tetes20/bldc_driver/bldc_driver_hw/3d_model/ESP32-C6-MINI-1-H4.step

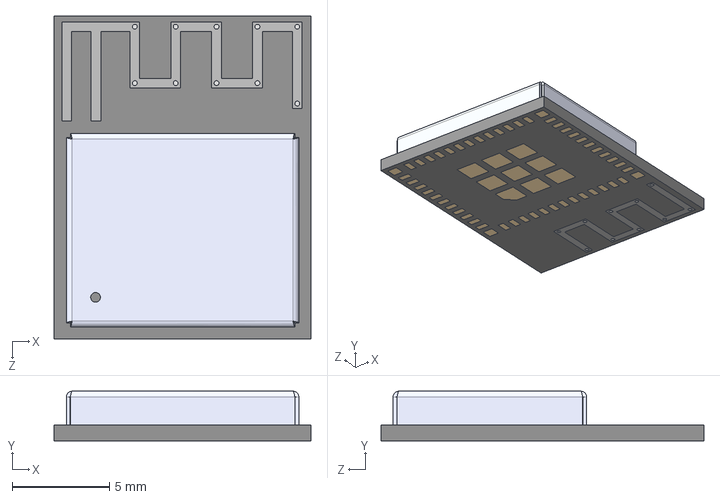
[picture p1: CAD file, 2025-04-09]
bldc_driver_hw/3d_model/ESP32-C6-MINI-1-H4.step
13.2 x 2.55 x 16.6 mm
