tetes20/bldc_driver/bldc_driver_hw/3d_model/LMLP0506M4R7DTAS.stp

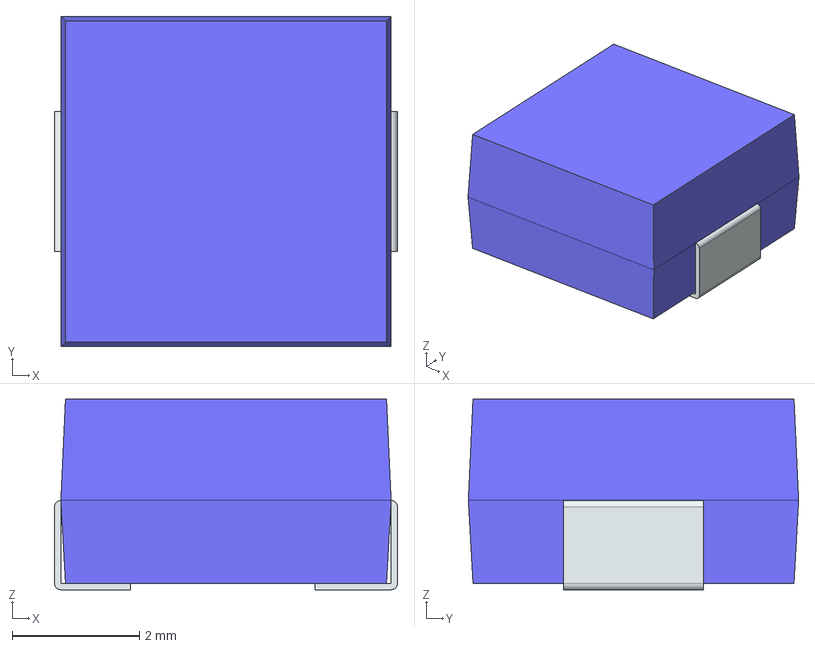
[picture p2: CAD file, 2025-04-08]
bldc_driver_hw/3d_model/LMLP0506M4R7DTAS.stp
5.40 x 5.20 x 3.00 mm
FilletPin1
FilletPin2
