tetes20/bldc_driver/bldc_driver_hw/3d_model/MR60-F.stp

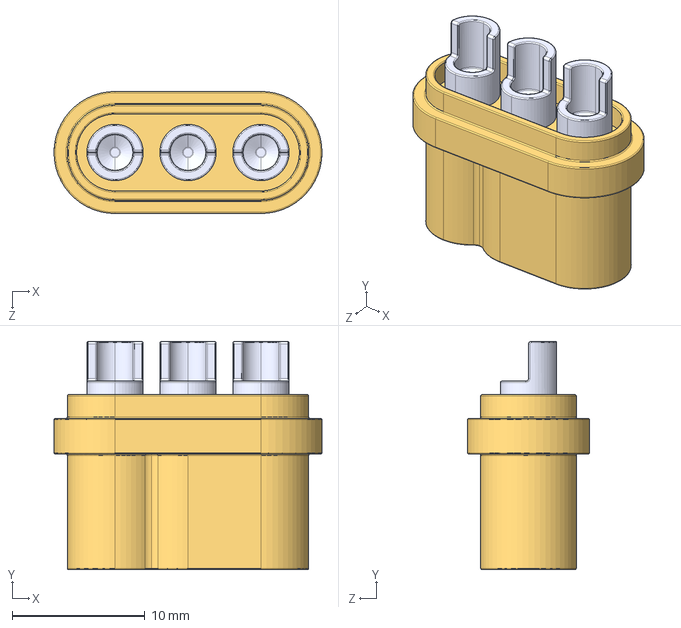
[picture p3: CAD file, 2025-04-08]
bldc_driver_hw/3d_model/MR60-F.stp
20.2 x 17.2 x 9.20 mm
Plug
Pin x 3
