tetes20/bldc_driver/bldc_driver_hw/3d_model/DRV8328BRUYR.stp

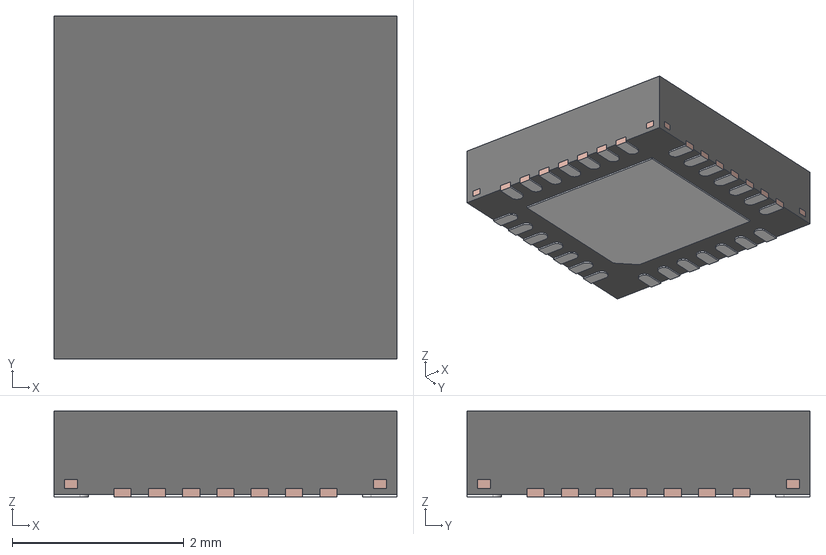
[picture p4: CAD file, 2025-04-05]
bldc_driver_hw/3d_model/DRV8328BRUYR.stp
4.00 x 4.00 x 1.00 mm
FRAME
