tetes20/bldc_driver/bldc_driver_hw/3d_model/DRV8334PHPR.stp

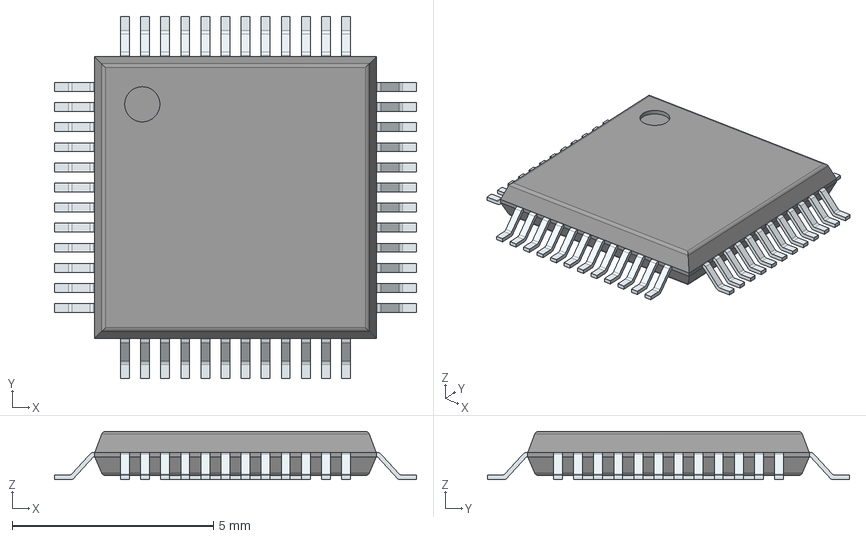
[picture p5: CAD file, 2025-04-03]
bldc_driver_hw/3d_model/DRV8334PHPR.stp
9.00 x 9.00 x 1.20 mm
PinsArrayLR
PinsArrayTB
ThermalPad
