tetes20/bldc_driver/bldc_driver_hw/plots/bldc_driver_hw__Assembly.pdf

1 | 2 | 3 | 4 | 5 | 6

A

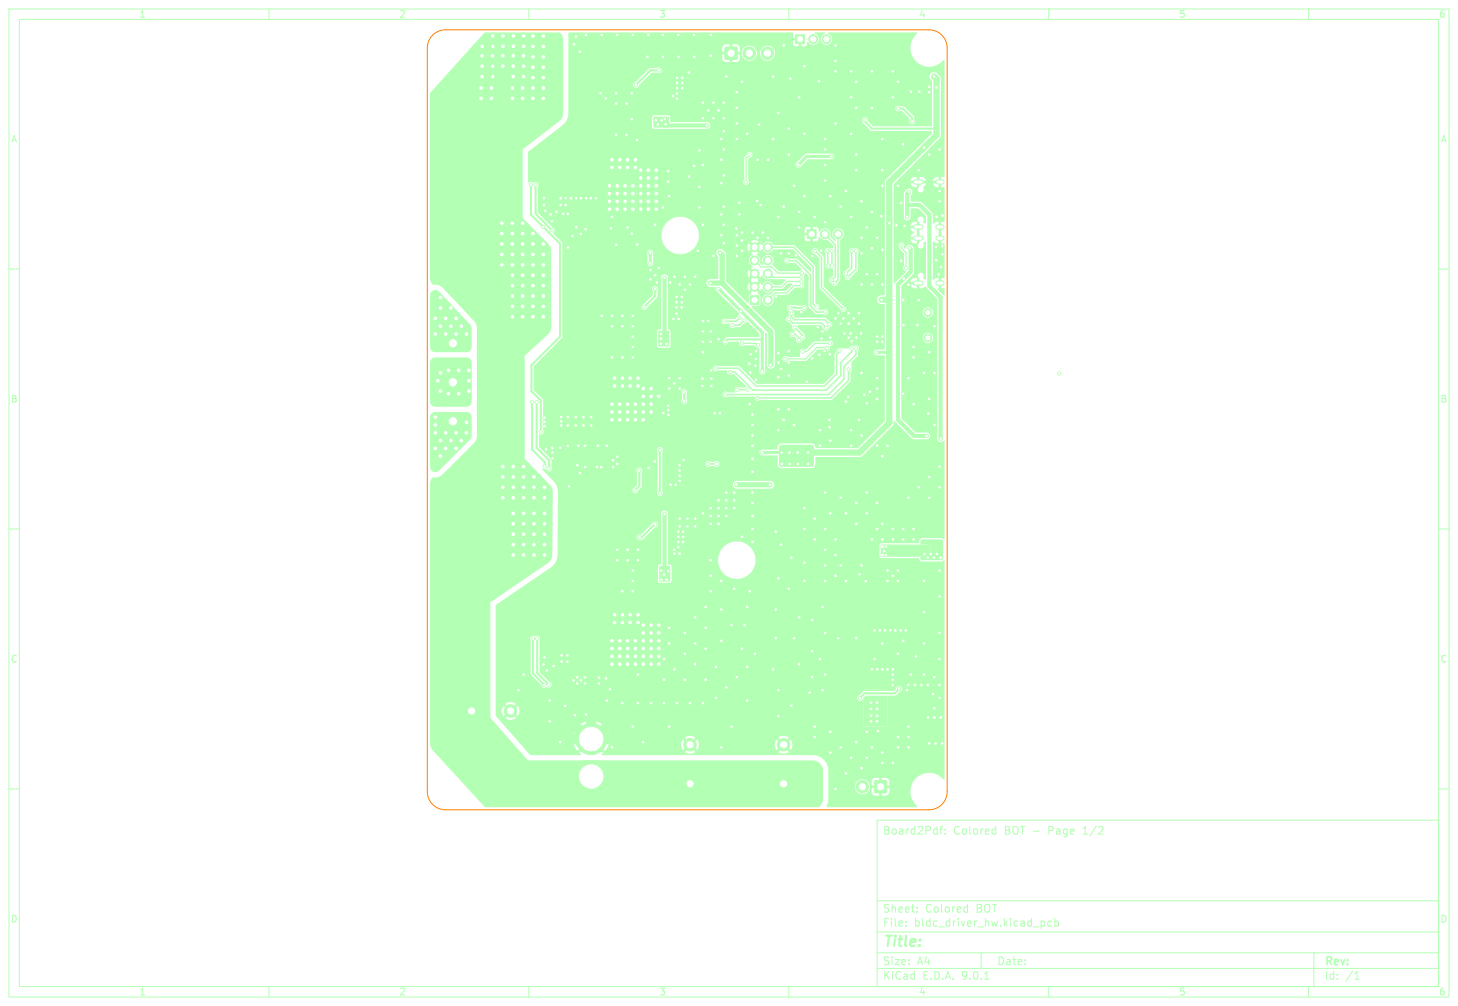
[picture p6: page 1]
D Date: KiCad; E.D.A. 9.0.1 Size: A4; Rev:; Id: /1 Title: File: bldc_driver_hw.kicad_pcb Sheet: Colored; BOT Board2Pdf:; Colored; BOT -; Page

1 | 2 | 3 | 4 | 5 | 6 1 | 2 | 3 | 4 | 5 | 6 ABCD | ABCD Date: KiCad | E.D.A. 9.0.1 Size: A4 | Rev:

## PHASE U

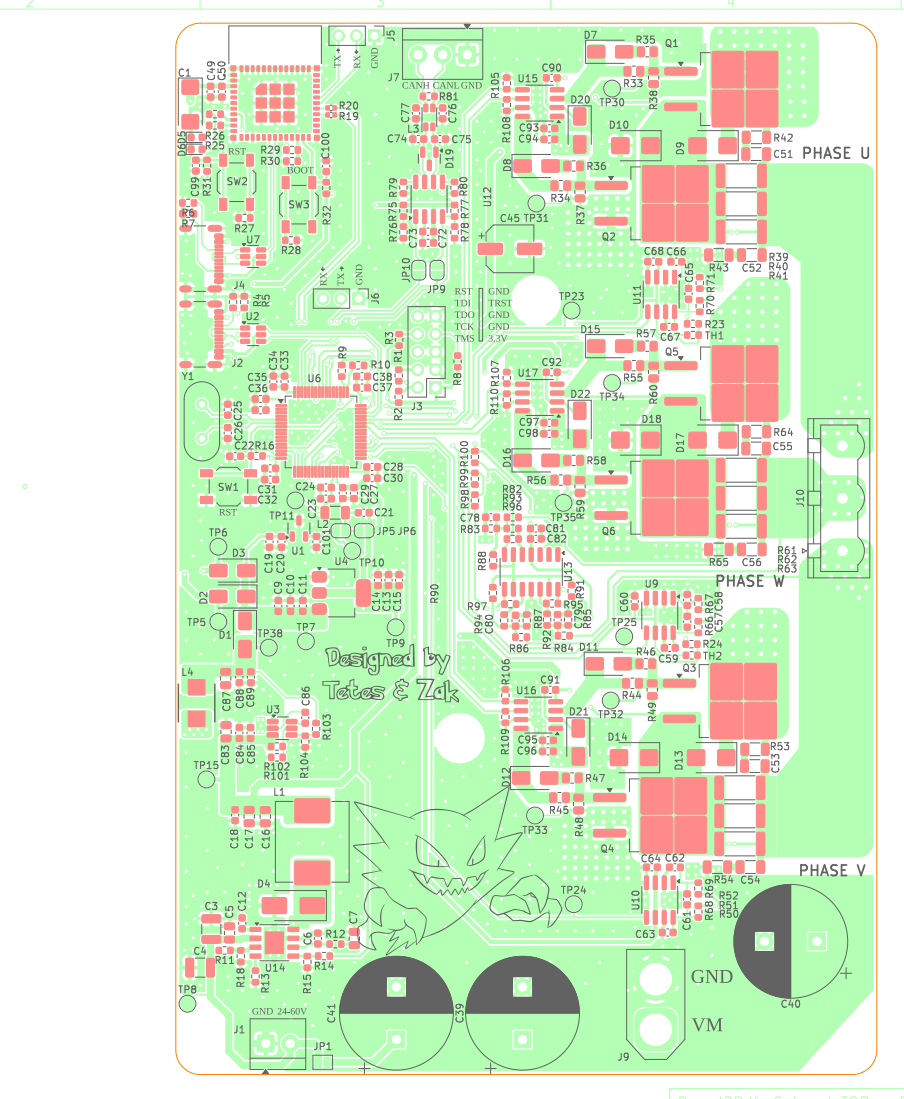
[picture p7: page 2]
