tetes20/bldc_driver/bldc_driver_hw/plots/bldc_driver_hw.pdf

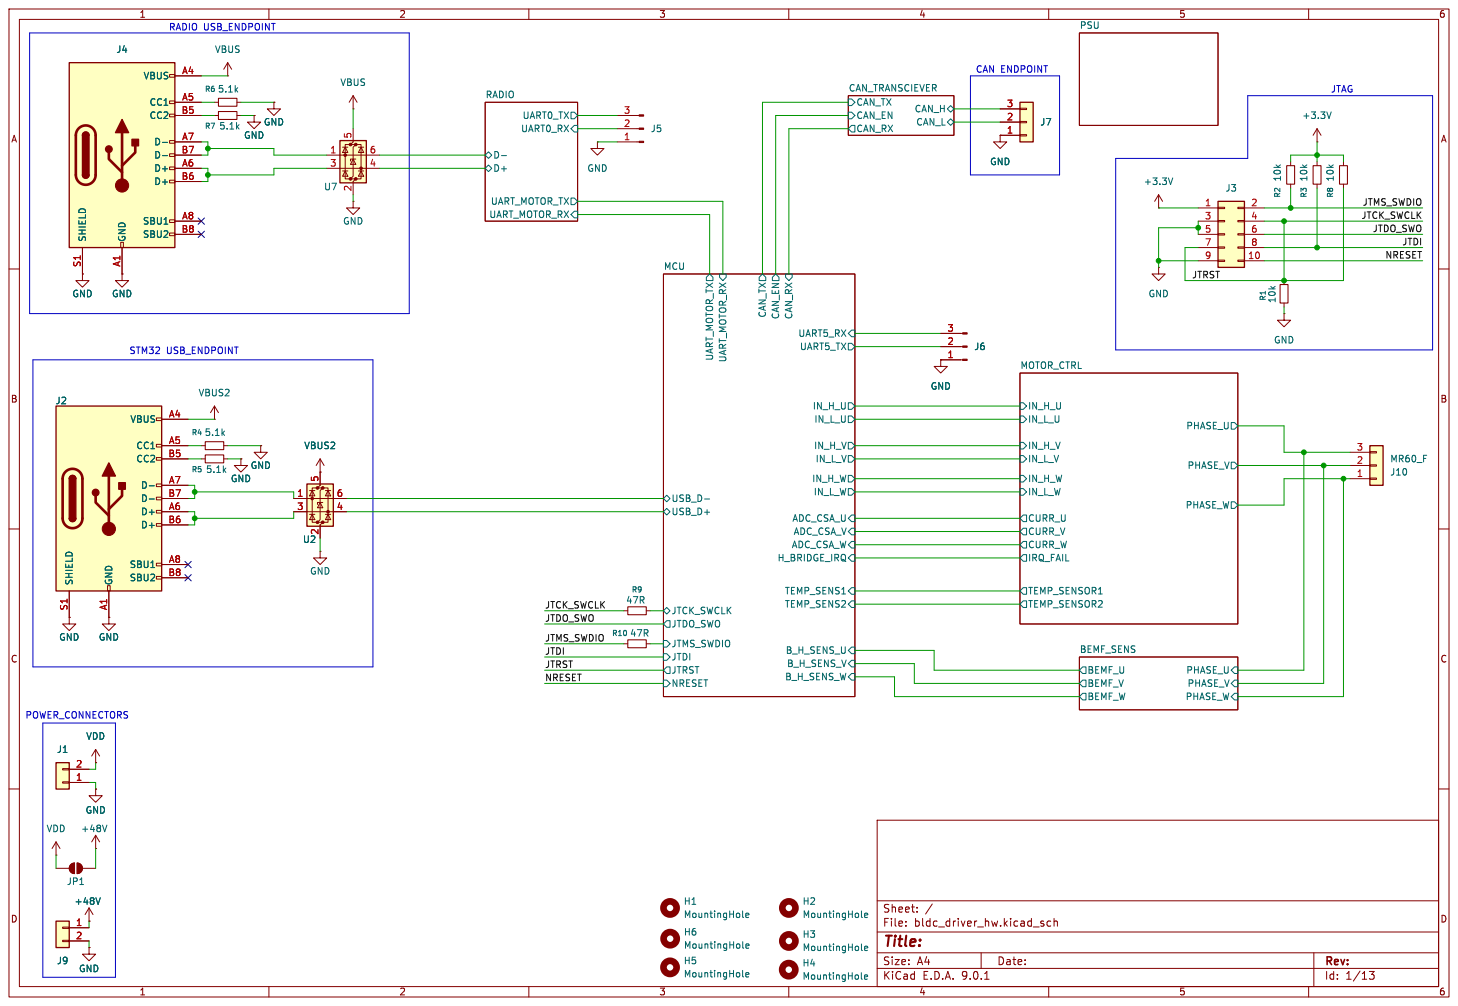
[picture p8: page 1]

Id: 1/13 Title: File: bldc_driver_hw.kicad_sch Sheet: /

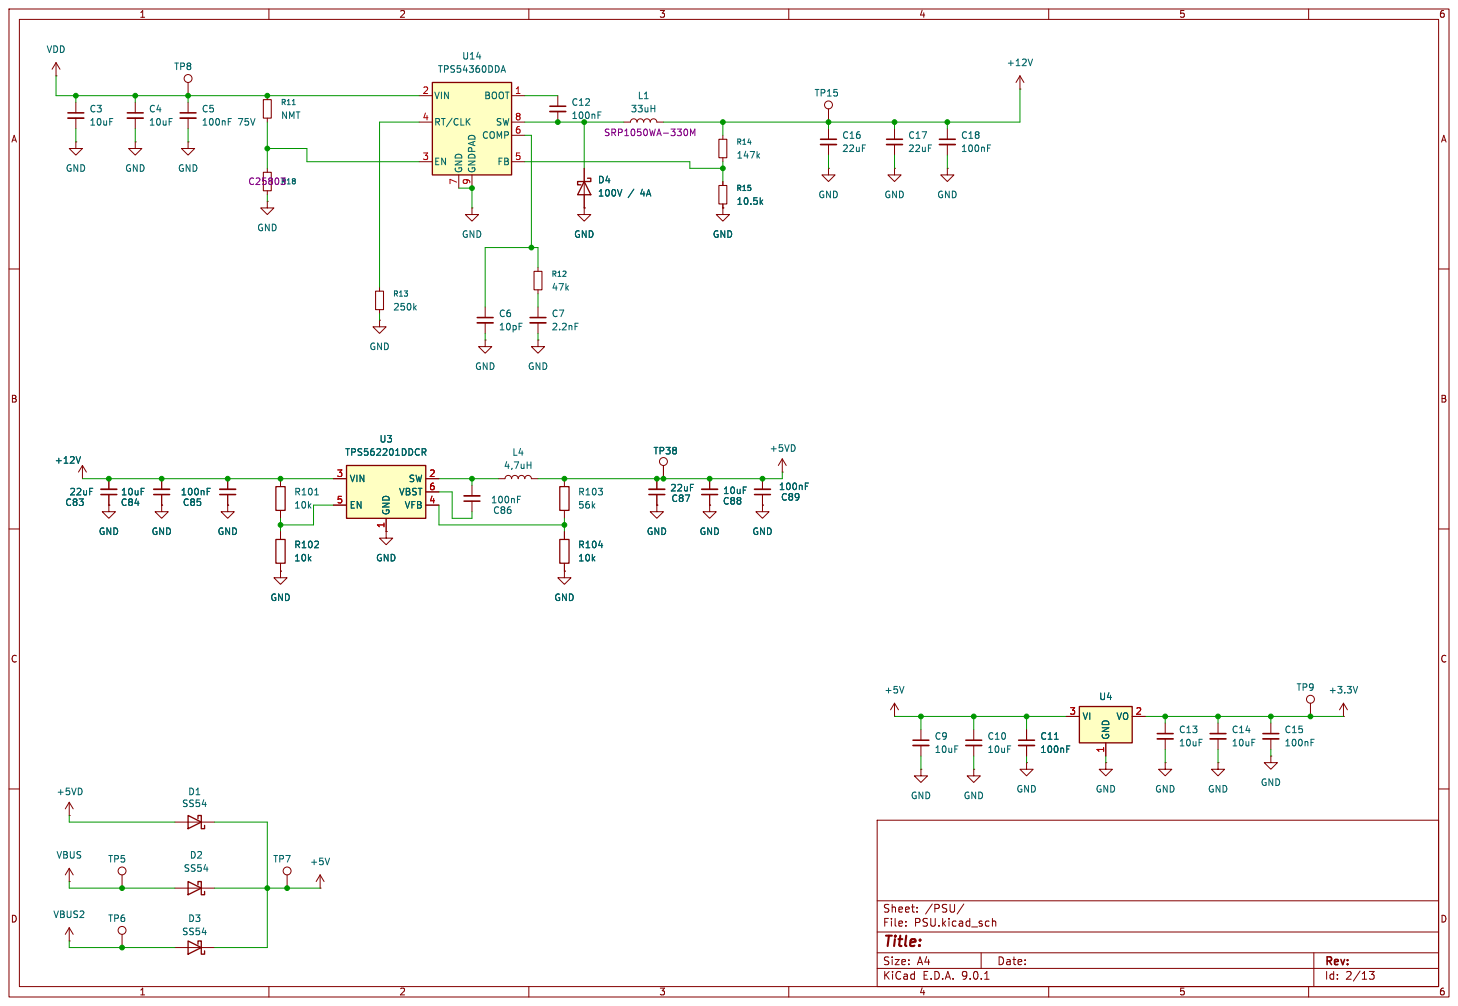
[picture p9: page 2]

9 BOOT 1 SW 8 COMP 6 FB 5 U14 TPS54360DDA GND

1 SW 2 VBST 6 VFB 4 U3 TPS562201DDCR GND

1 SW 2 VBST 6 VFB 4 GND

Id: 2/13 Title: File: PSU.kicad_sch Sheet: /PSU/

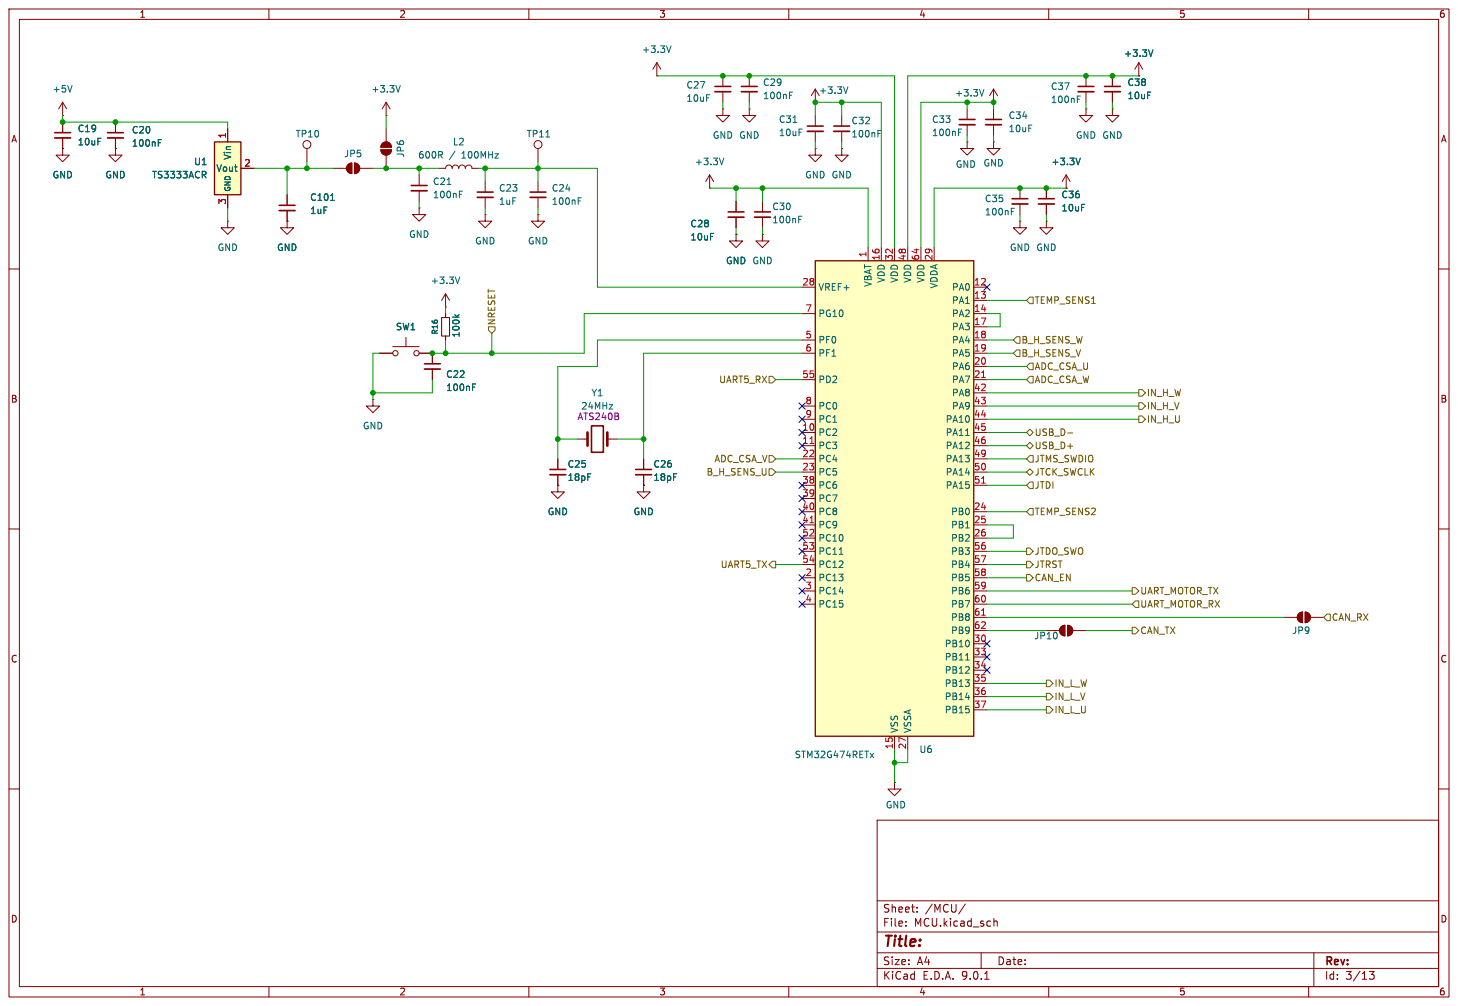
[picture p10: page 3]

1 VDD 16 VDD 32 VSS 15 VDD 48 VSSA 27 VDD 64 VDDA 29 PA0 12 PA1 13 PA2 14 PA3 17 PA4 18 PA5 19 PA6 20 PA7 21 PA8 42 PA9 43 PA10 44 PA11 45 PA12 46 PA13 49 PA14 50 PA15 51 PB0 24 PB1 25 PB2 26 PB3 56 PB4 57 PB5 58 PB6 59 PB7 60 PB8 61 PB9 62 PB10 30 PB11 33 PB12 34 PB13 35 PB14 36 PB15 37 U6 STM32G474RETx

Id: 3/13 Title: File: MCU.kicad_sch Sheet: /MCU/

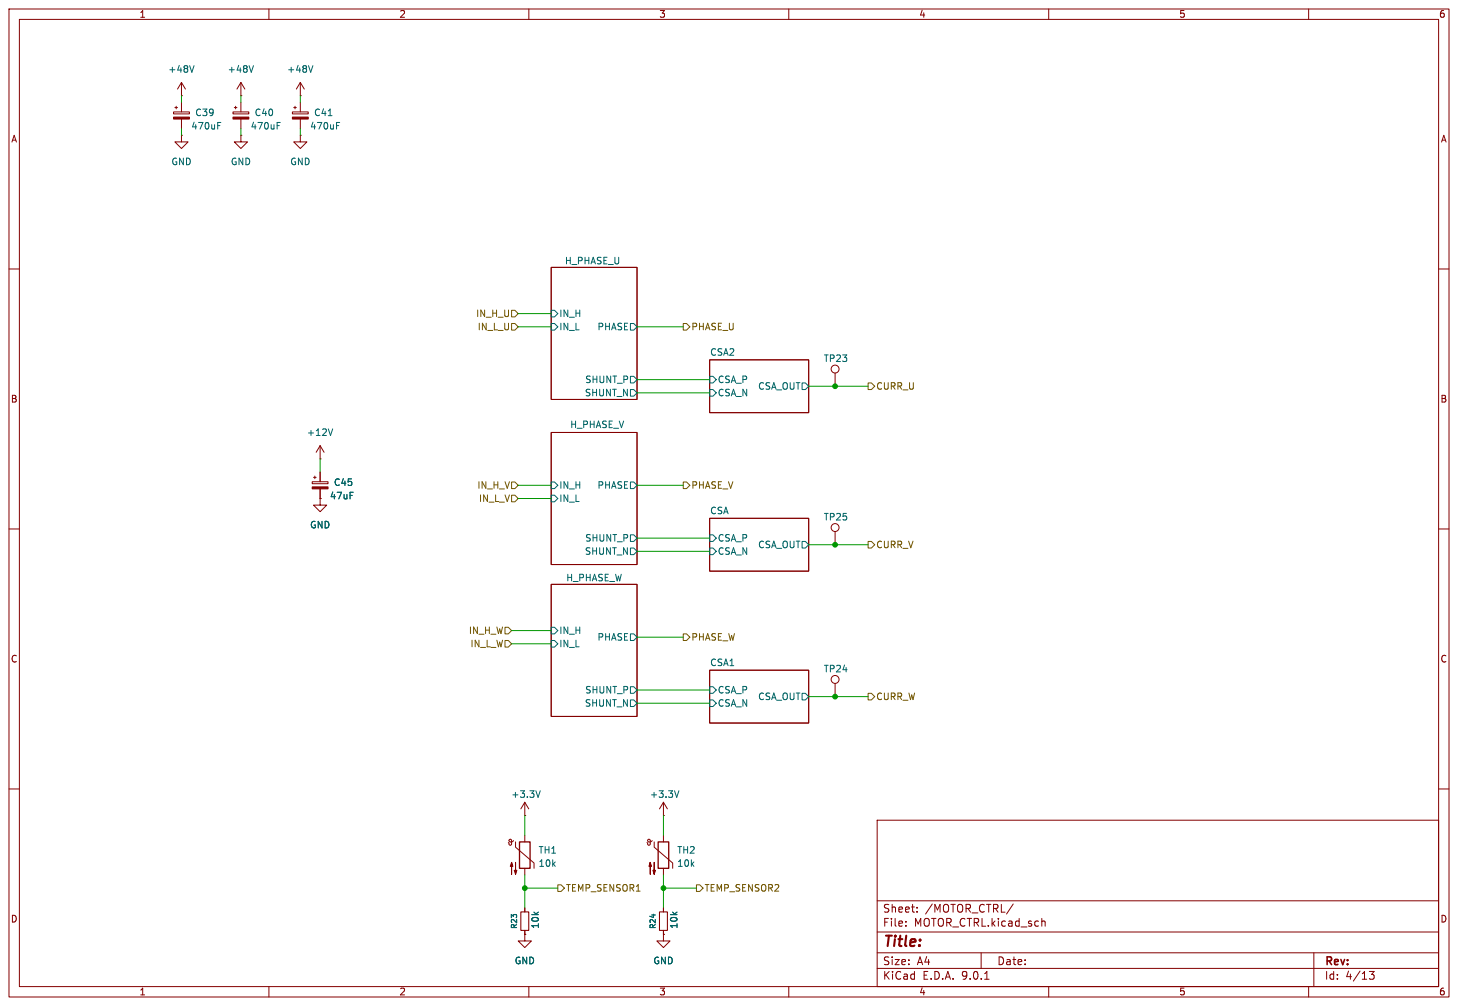
[picture p11: page 4]

Id: 4/13 Title: File: MOTOR_CTRL.kicad_sch Sheet: /MOTOR_CTRL/

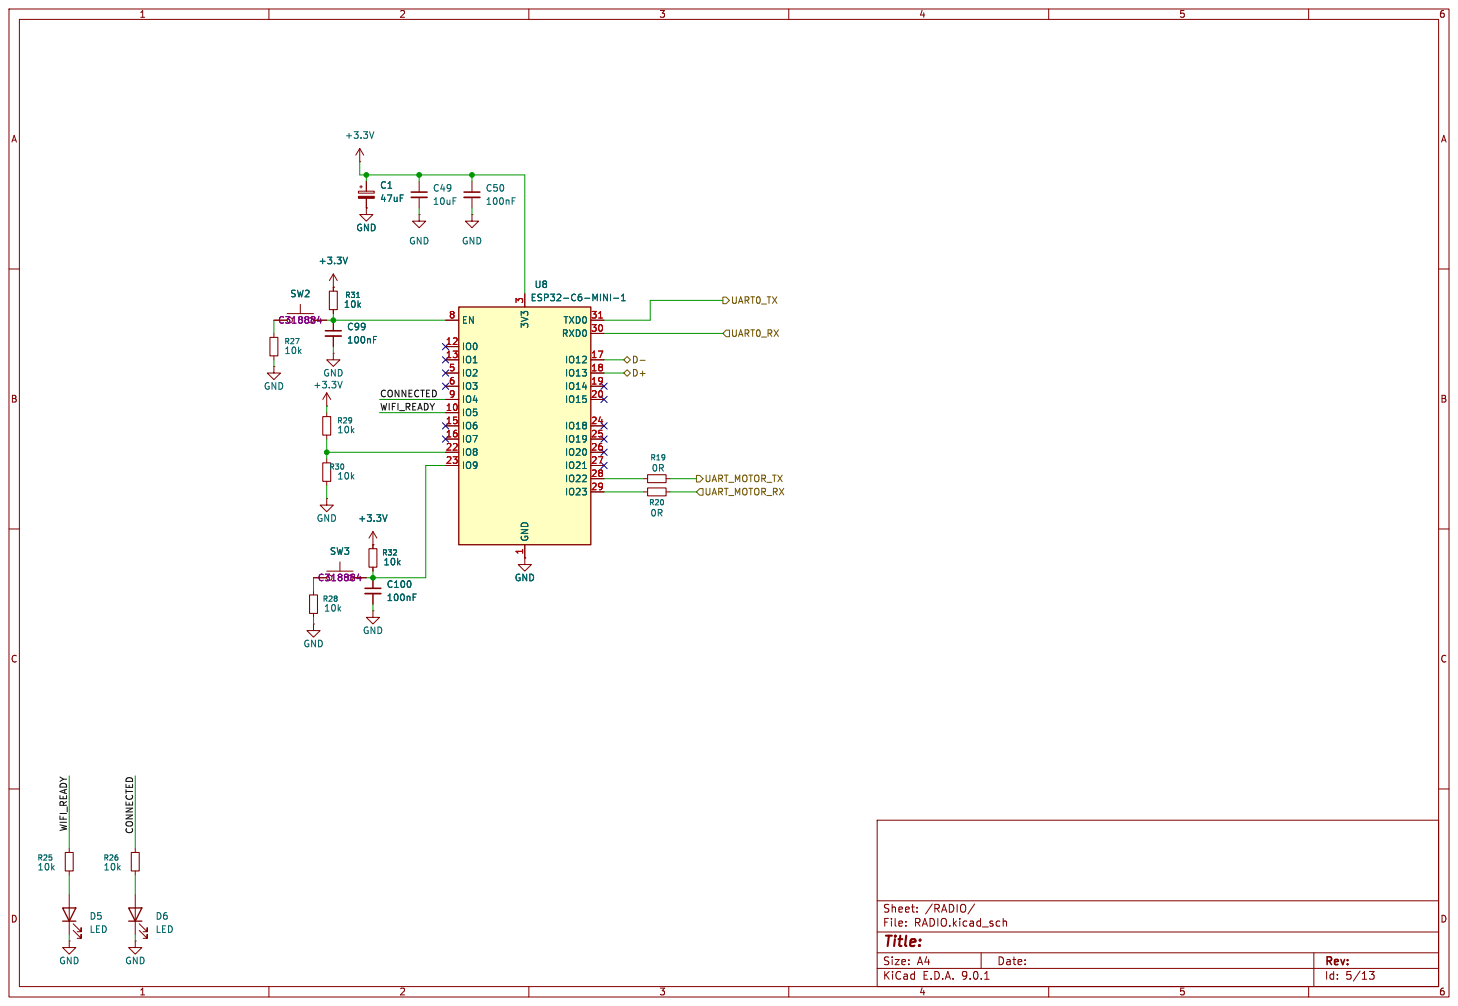
[picture p12: page 5]

Id: 5/13 Title: File: RADIO.kicad_sch Sheet: /RADIO/

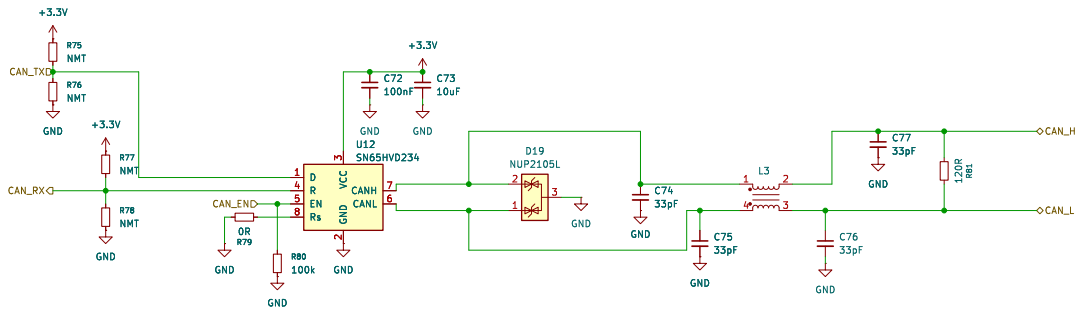
[picture p13: page 6]

33pF GND C74
L3 GND
Id: 13/13 Title: File: CAN_TRANSCIEVER.kicad_sch Sheet: /CAN_TRANSCIEVER/ C74

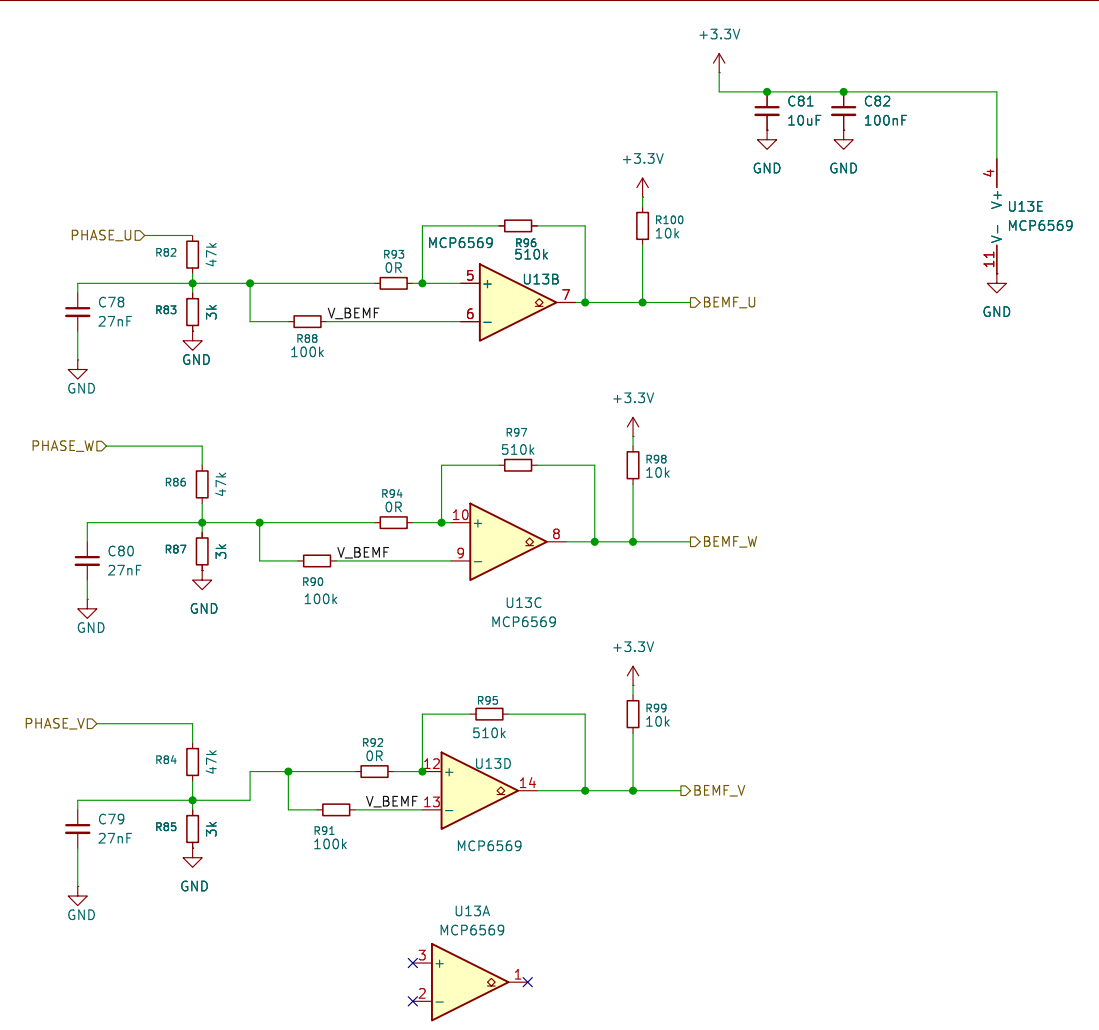
[picture p14: page 7]

Id: 14/13 Title: File: BEMF_SENS.kicad_sch Sheet: /BEMF_SENS/

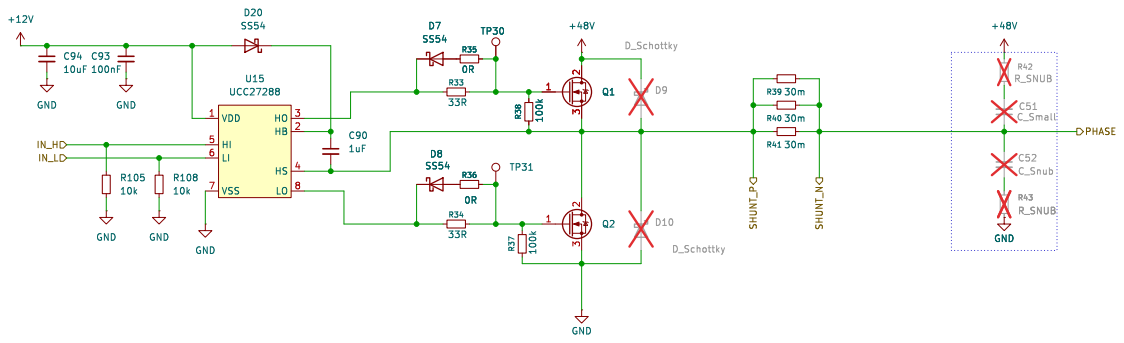
[picture p15: page 8]

Id: 6/13 Title: File: H_BRIDGE.kicad_sch Sheet: /MOTOR_CTRL/H_PHASE_U/

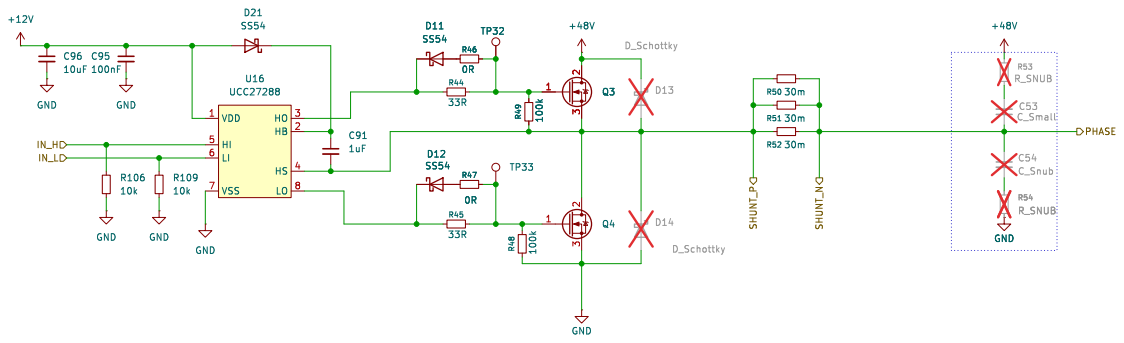
[picture p16: page 9]

Id: 7/13 Title: File: H_BRIDGE.kicad_sch Sheet: /MOTOR_CTRL/H_PHASE_W/

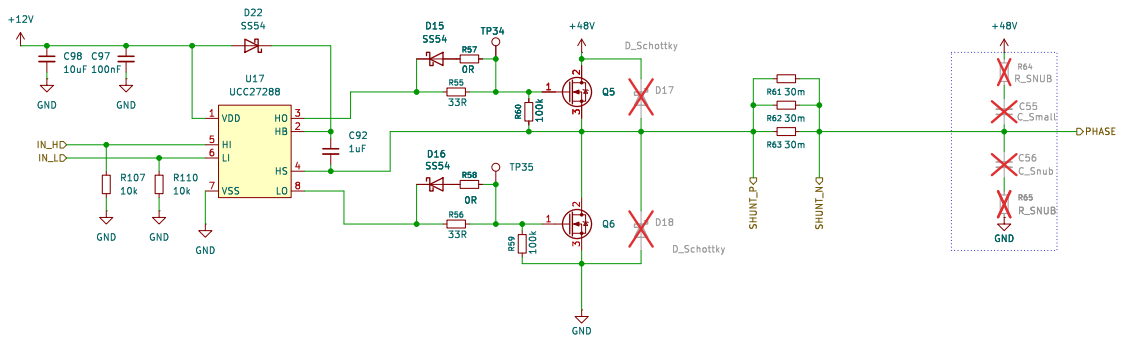
[picture p17: page 10]

Id: 8/13 Title: File: H_BRIDGE.kicad_sch Sheet: /MOTOR_CTRL/H_PHASE_V/

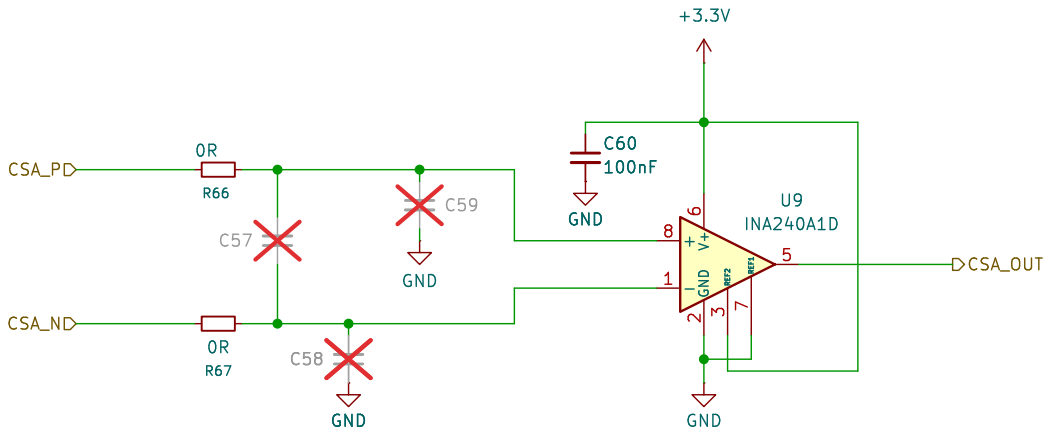
[picture p18: page 11]

Id: 9/13 Title: File: CSA.kicad_sch Sheet: /MOTOR_CTRL/CSA/

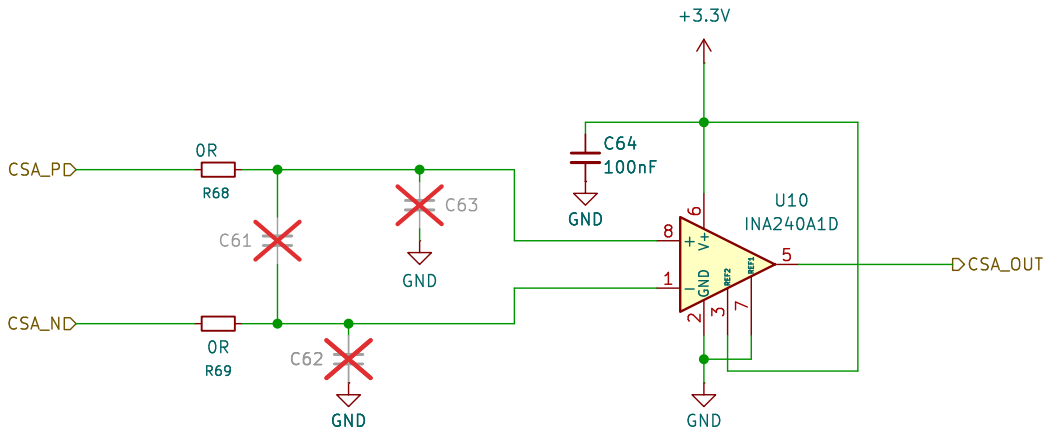
[picture p19: page 12]

Id: 10/13 Title: File: CSA.kicad_sch Sheet: /MOTOR_CTRL/CSA1/

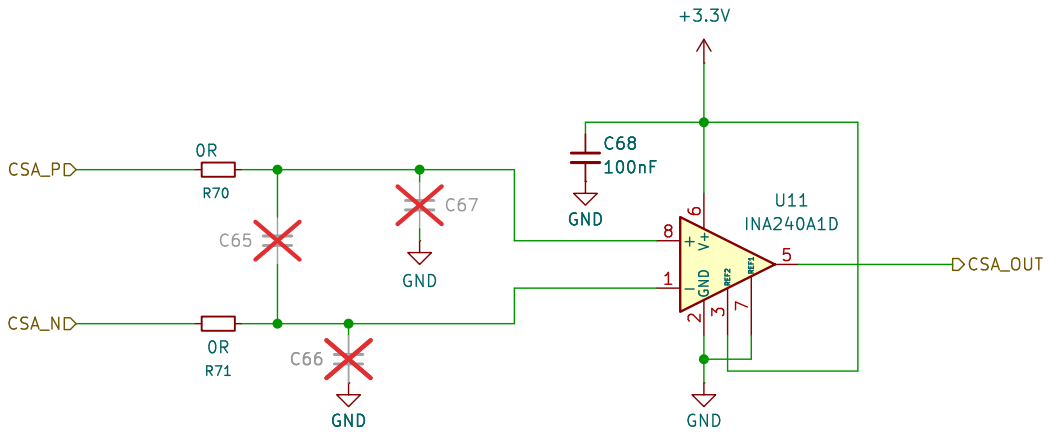
[picture p20: page 13]

Id: 11/13 Title: File: CSA.kicad_sch Sheet: /MOTOR_CTRL/CSA2/
