tetes20/bldc_driver/bldc_driver_hw/bldc_driver_hw.kicad_pcb

## KiCad design bldc_driver_hw/bldc_driver_hw.kicad_pcb (2025-04-18)

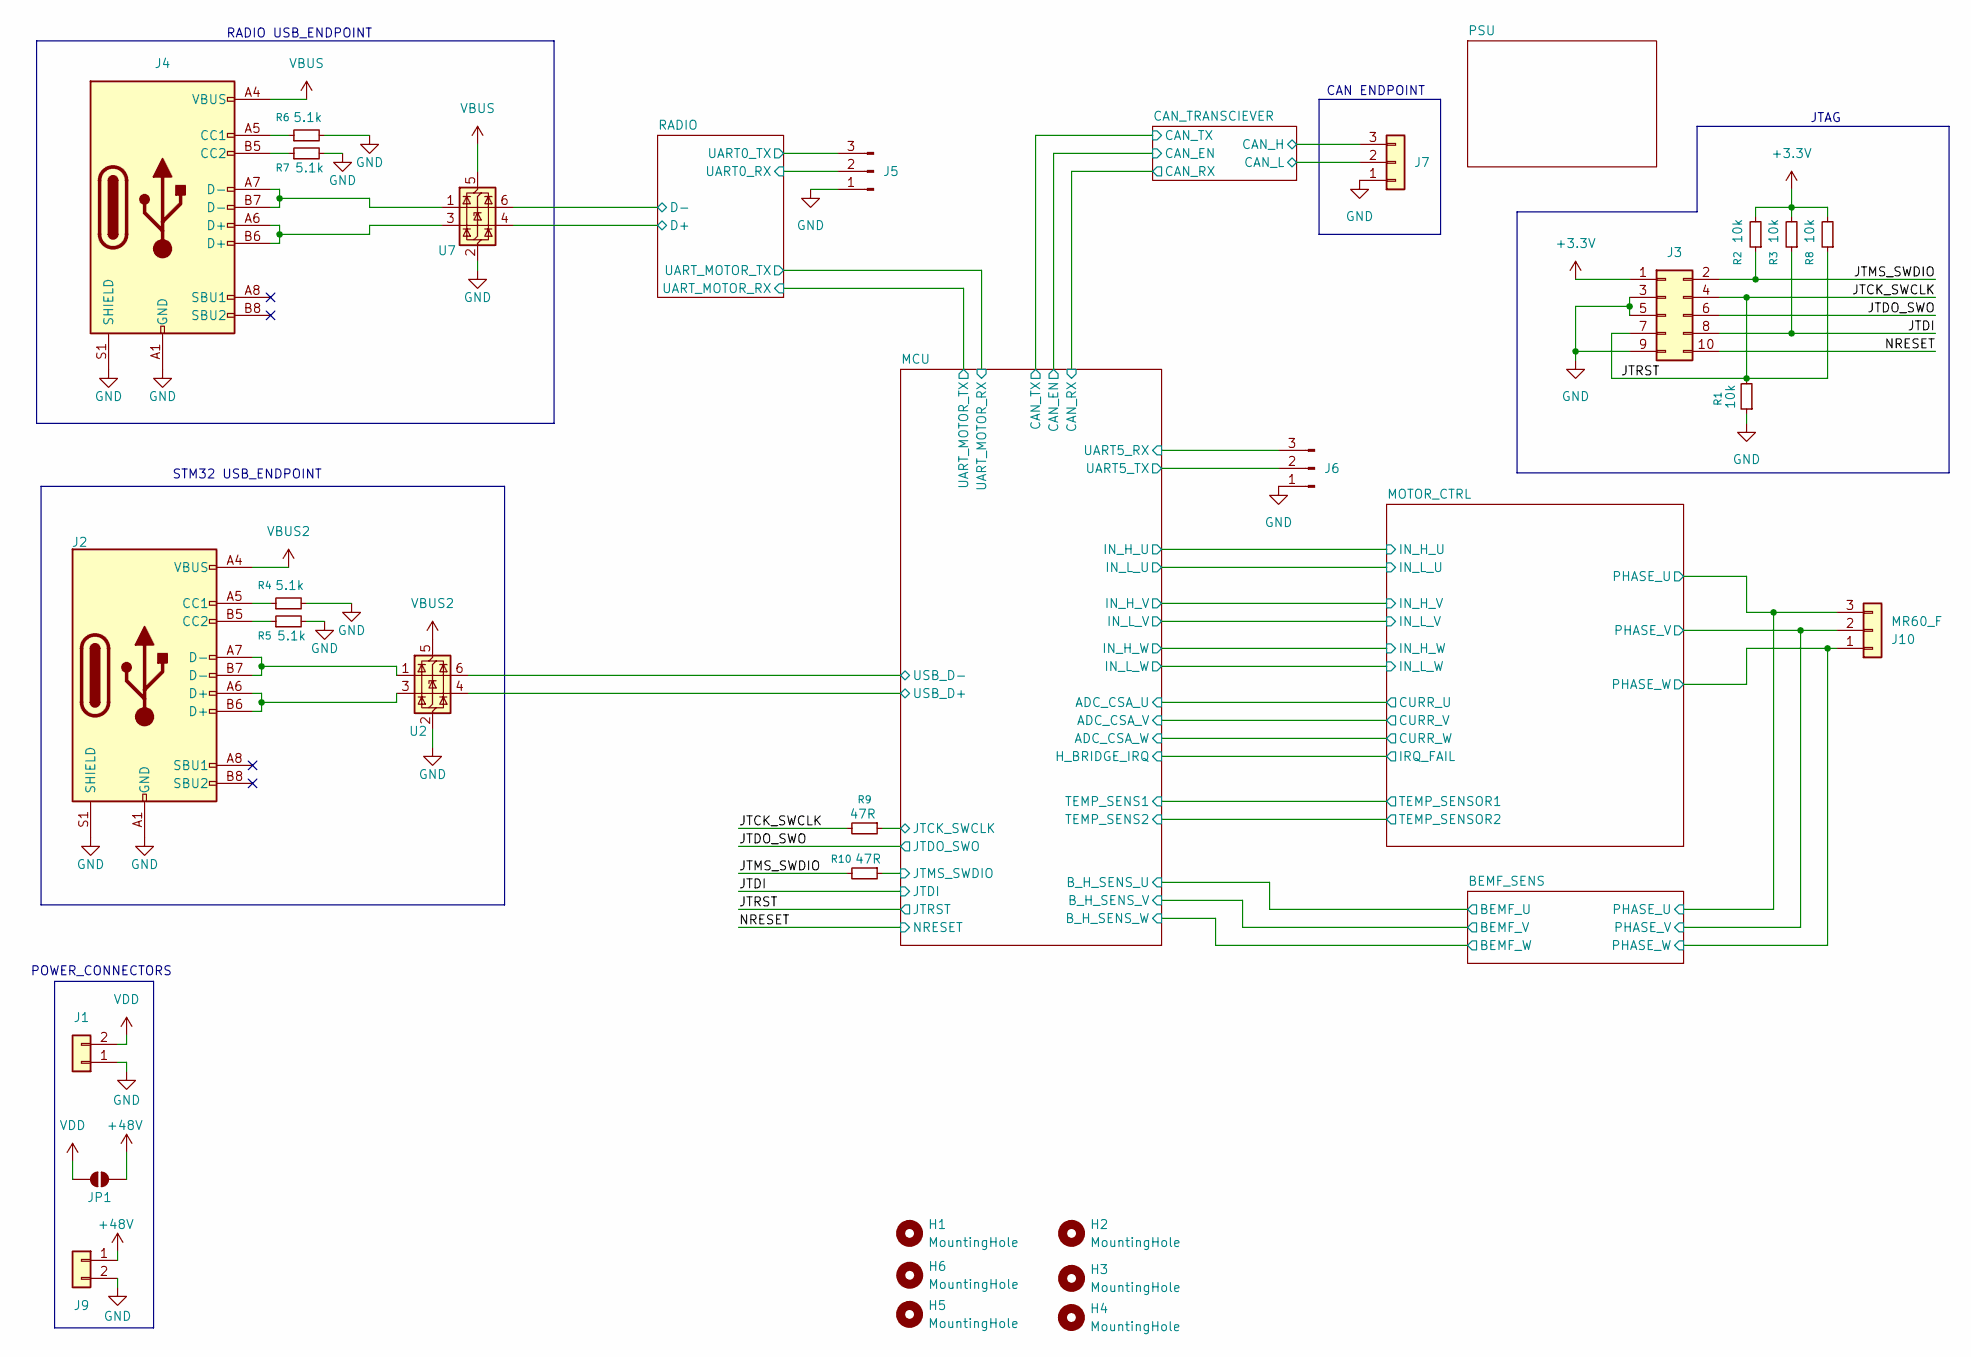
[picture p21: schematic bldc_driver_hw.kicad_sch]

Parts:
H1, H2, H3, H4, H5, H6: MountingHole; MountingHole_3.2mm_M3
J1: Conn_01x02; TerminalBlock_4Ucon_1x02_P3.50mm_Horizontal
J2, J4: USB_C_Receptacle_USB2.0_16P; USB_C_Receptacle_GCT_USB4105-xx-A_16P_TopMnt_Horizontal
J3: JTAG_CONN; PinHeader_2x05_P2.54mm_Vertical
J5, J6: Conn_01x03_Pin; PinHeader_1x03_P2.54mm_Vertical
J7: Conn_01x03; TerminalBlock_4Ucon_1x03_P3.50mm_Horizontal
J9: Conn_01x02; AMASS_XT60-F_1x02_P7.20mm_Vertical
J10: MR60_F; PhoenixContact_GMSTBVA_2,5_3-G_1x03_P7.50mm_Vertical
JP1: SolderJumper_2_Open; SolderJumper-2_P1.3mm_Open_Pad1.0x1.5mm
R1, R2, R3, R8: 10k; R_0603_1608Metric; LCSC C25804
R4, R5, R6, R7: 5.1k; R_0603_1608Metric; LCSC C23186
R9, R10: 47R; R_0603_1608Metric; LCSC C23182
U2, U7: USBLC6-2SC6; SOT-23-6

Connections:
+3.3V: J3.1, R2.2, R3.2, R8.2; also elsewhere on the board
+48V: J9.1, JP1.1 (A); also elsewhere on the board
/BEMF_SENS/PHASE_U: J10.3; also elsewhere on the board
/BEMF_SENS/PHASE_V: J10.2; also elsewhere on the board
/BEMF_SENS/PHASE_W: J10.1; also elsewhere on the board
/CAN_TRANSCIEVER/CAN_H: J7.3; also elsewhere on the board
/CAN_TRANSCIEVER/CAN_L: J7.2; also elsewhere on the board
/JTCK_SWCLK: J3.4, J3.7, R1.2, R8.1, R9.2; also elsewhere on the board
/JTDI: J3.8, R3.1; also elsewhere on the board
/JTDO_SWO: J3.6; also elsewhere on the board
/JTMS_SWDIO: J3.2, R2.1, R10.2
/MCU/JTCK_SWCLK: R9.1; also elsewhere on the board
/MCU/JTMS_SWDIO: R10.1; also elsewhere on the board
/MCU/UART5_RX: J6.3; also elsewhere on the board
/MCU/UART5_TX: J6.2; also elsewhere on the board
/MCU/USB_D+: U2.4 (I/O2); also elsewhere on the board
/MCU/USB_D-: U2.6 (I/O1); also elsewhere on the board
/NRESET: J3.10; also elsewhere on the board
/RADIO/D+: U7.4 (I/O2); also elsewhere on the board
/RADIO/D-: U7.6 (I/O1); also elsewhere on the board
/RADIO/UART0_RX: J5.2; also elsewhere on the board
/RADIO/UART0_TX: J5.3; also elsewhere on the board
GND: J1.1, J2.A1 (GND), J2.A12 (GND), J2.B1 (GND), J2.B12 (GND), J2.S1 (SHIELD), J3.3, J3.5, J3.9, J4.A1 (GND), J4.A12 (GND), J4.B1 (GND), J4.B12 (GND), J4.S1 (SHIELD), J5.1, J6.1, J7.1, J9.2, R1.1, R4.2, R5.2, R6.2, R7.2, U2.2 (GND), U7.2 (GND); also elsewhere on the board
unnamed: J2.A5 (CC1), R4.1
unnamed: J2.B5 (CC2), R5.1
unnamed: J2.A6 (D+), J2.B6 (D+), U2.3 (I/O2)
unnamed: J2.A7 (D-), J2.B7 (D-), U2.1 (I/O1)
unnamed: J4.A5 (CC1), R6.1
unnamed: J4.B5 (CC2), R7.1
unnamed: J4.A6 (D+), J4.B6 (D+), U7.3 (I/O2)
unnamed: J4.A7 (D-), J4.B7 (D-), U7.1 (I/O1)
VBUS: J4.A4 (VBUS), J4.A9 (VBUS), J4.B4 (VBUS), J4.B9 (VBUS), U7.5 (VBUS); also elsewhere on the board
VBUS2: J2.A4 (VBUS), J2.A9 (VBUS), J2.B4 (VBUS), J2.B9 (VBUS), U2.5 (VBUS); also elsewhere on the board
VDD: J1.2, JP1.2 (B); also elsewhere on the board

Notes on the sheet:
STM32 USB_ENDPOINT
JTAG
RADIO USB_ENDPOINT
CAN ENDPOINT
POWER_CONNECTORS

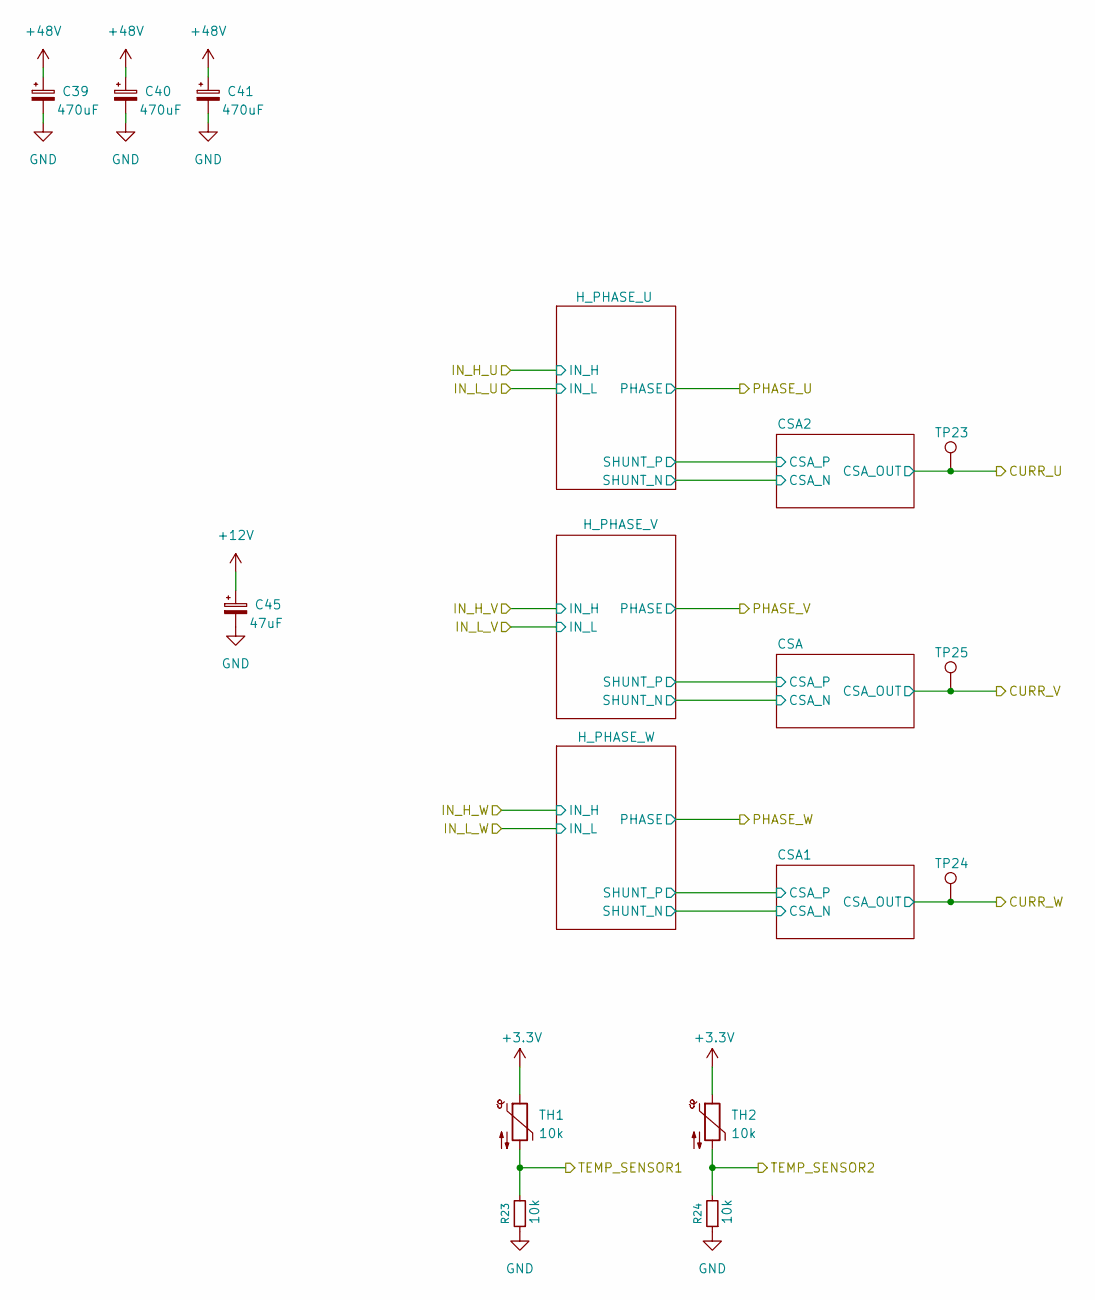
[picture p22: schematic MOTOR_CTRL.kicad_sch]

Parts:
C39, C40, C41: 470uF; CP_Radial_D16.0mm_P7.50mm
C45: 47uF; CP_Elec_6.3x5.4
R23, R24: 10k; R_0603_1608Metric; LCSC C25804
TH1, TH2: 10k; R_0603_1608Metric
TP23, TP24, TP25: TestPoint; TestPoint_Pad_D2.0mm

Connections:
+3.3V: TH1.1, TH2.1; also elsewhere on the board
+12V: C45.1; also elsewhere on the board
+48V: C39.1, C40.1, C41.1; also elsewhere on the board
/MCU/ADC_CSA_U: TP23.1; also elsewhere on the board
/MCU/ADC_CSA_V: TP25.1; also elsewhere on the board
/MCU/ADC_CSA_W: TP24.1; also elsewhere on the board
/MCU/TEMP_SENS1: R23.2, TH1.2; also elsewhere on the board
/MCU/TEMP_SENS2: R24.2, TH2.2; also elsewhere on the board
GND: C39.2, C40.2, C41.2, C45.2, R23.1, R24.1; also elsewhere on the board

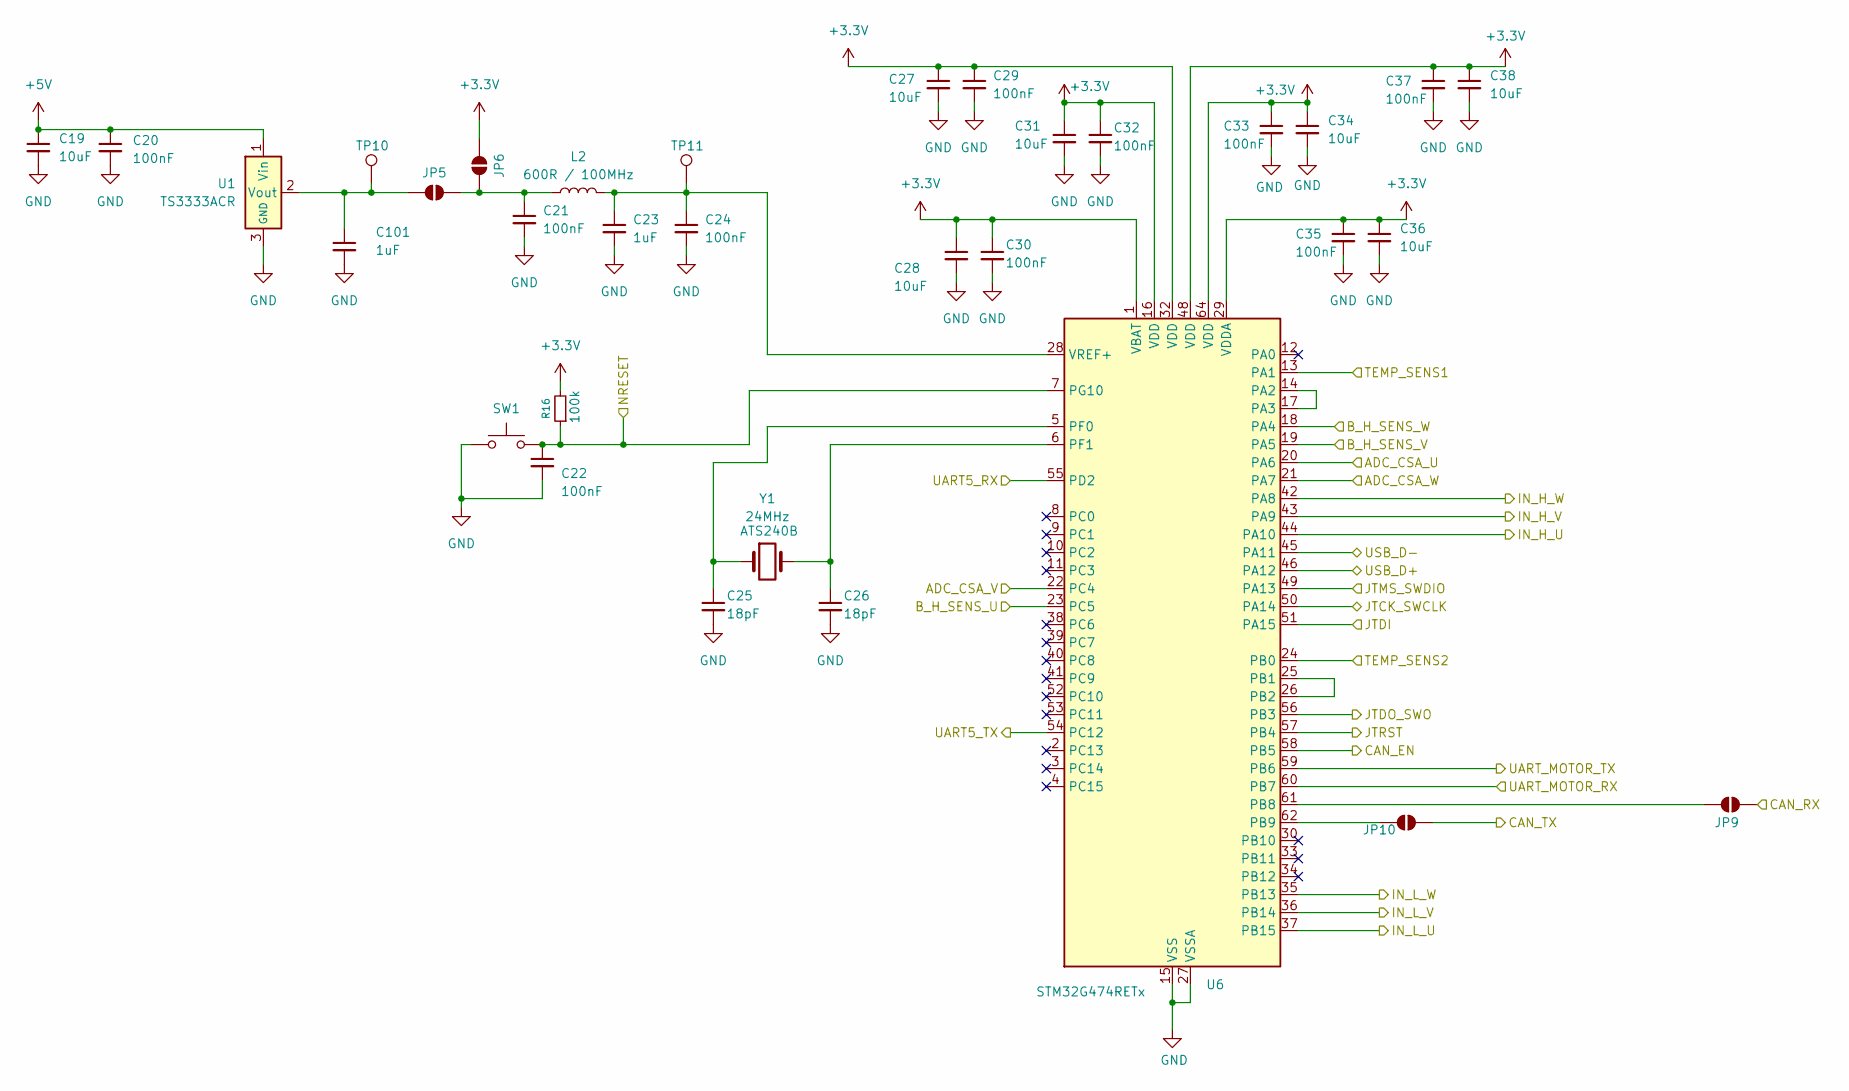
[picture p23: schematic MCU.kicad_sch]

Parts:
C19, C27, C28, C31, C34, C36, C38: 10uF; C_0603_1608Metric; LCSC C96446
C20, C21, C22, C24, C29, C30, C32, C33, C35, C37: 100nF; C_0603_1608Metric; LCSC C14663
C23, C101: 1uF; C_0603_1608Metric; LCSC C15849
C25, C26: 18pF; C_0603_1608Metric; LCSC C1647
JP5, JP6, JP9, JP10: SolderJumper_2_Open; SolderJumper-2_P1.3mm_Open_RoundedPad1.0x1.5mm
L2: 600R / 100MHz; R_1206_3216Metric
R16: 100k; R_0603_1608Metric; LCSC C25803
SW1: SW_Push; SW_SPST_TL3342; LCSC C318884
TP10, TP11: TestPoint; TestPoint_Pad_D2.0mm
U1: TS3333ACR; SOT-23-3
U6: STM32G474RETx; LQFP-64_10x10mm_P0.5mm
Y1: 24MHz; Crystal_HC49-U_Vertical

Connections:
+3.3V: C27.1, C28.1, C29.1, C30.1, C31.1, C32.1, C33.1, C34.1, C35.1, C36.1, C37.1, C38.1, JP6.1 (A), R16.2, U6.1 (VBAT), U6.16 (VDD), U6.29 (VDDA), U6.32 (VDD), U6.48 (VDD), U6.64 (VDD); also elsewhere on the board
+5V: C19.1, C20.1, U1.1 (Vin); also elsewhere on the board
/BEMF_SENS/BEMF_U: U6.23 (PC5); also elsewhere on the board
/BEMF_SENS/BEMF_V: U6.19 (PA5); also elsewhere on the board
/BEMF_SENS/BEMF_W: U6.18 (PA4); also elsewhere on the board
/CAN_TRANSCIEVER/CAN_EN: U6.58 (PB5); also elsewhere on the board
/CAN_TRANSCIEVER/CAN_RX: JP9.2 (B); also elsewhere on the board
/CAN_TRANSCIEVER/CAN_TX: JP10.2 (B); also elsewhere on the board
/JTCK_SWCLK: U6.57 (PB4); also elsewhere on the board
/JTDI: U6.51 (PA15); also elsewhere on the board
/JTDO_SWO: U6.56 (PB3); also elsewhere on the board
/MCU/ADC_CSA_U: U6.20 (PA6); also elsewhere on the board
/MCU/ADC_CSA_V: U6.22 (PC4); also elsewhere on the board
/MCU/ADC_CSA_W: U6.21 (PA7); also elsewhere on the board
/MCU/IN_H_U: U6.44 (PA10); also elsewhere on the board
/MCU/IN_H_V: U6.43 (PA9); also elsewhere on the board
/MCU/IN_H_W: U6.42 (PA8); also elsewhere on the board
/MCU/IN_L_U: U6.37 (PB15); also elsewhere on the board
/MCU/IN_L_V: U6.36 (PB14); also elsewhere on the board
/MCU/IN_L_W: U6.35 (PB13); also elsewhere on the board
/MCU/JTCK_SWCLK: U6.50 (PA14); also elsewhere on the board
/MCU/JTMS_SWDIO: U6.49 (PA13); also elsewhere on the board
/MCU/TEMP_SENS1: U6.13 (PA1); also elsewhere on the board
/MCU/TEMP_SENS2: U6.24 (PB0); also elsewhere on the board
/MCU/UART5_RX: U6.55 (PD2); also elsewhere on the board
/MCU/UART5_TX: U6.54 (PC12); also elsewhere on the board
/MCU/UART_MOTOR_RX: U6.60 (PB7); also elsewhere on the board
/MCU/UART_MOTOR_TX: U6.59 (PB6); also elsewhere on the board
/MCU/USB_D+: U6.46 (PA12); also elsewhere on the board
/MCU/USB_D-: U6.45 (PA11); also elsewhere on the board
/NRESET: C22.1, R16.1, SW1.2, U6.7 (PG10); also elsewhere on the board
GND: C19.2, C20.2, C21.2, C22.2, C23.2, C24.2, C25.2, C26.2, C27.2, C28.2, C29.2, C30.2, C31.2, C32.2, C33.2, C34.2, C35.2, C36.2, C37.2, C38.2, C101.2, SW1.1, U1.3 (GND), U6.15 (VSS), U6.27 (VSSA), U6.31 (VSS), U6.47 (VSS), U6.63 (VSS); also elsewhere on the board
unnamed: C101.1, JP5.1 (A), TP10.1, U1.2 (Vout)
unnamed: C21.1, JP5.2 (B), JP6.2 (B), L2.1
unnamed: JP9.1 (A), U6.61 (PB8)
unnamed: JP10.1 (A), U6.62 (PB9)
unnamed: U6.14 (PA2), U6.17 (PA3)
unnamed: U6.25 (PB1), U6.26 (PB2)
unnamed: C25.1, U6.5 (PF0), Y1.1
unnamed: C26.1, U6.6 (PF1), Y1.2
unnamed: C23.1, C24.1, L2.2, TP11.1, U6.28 (VREF+)

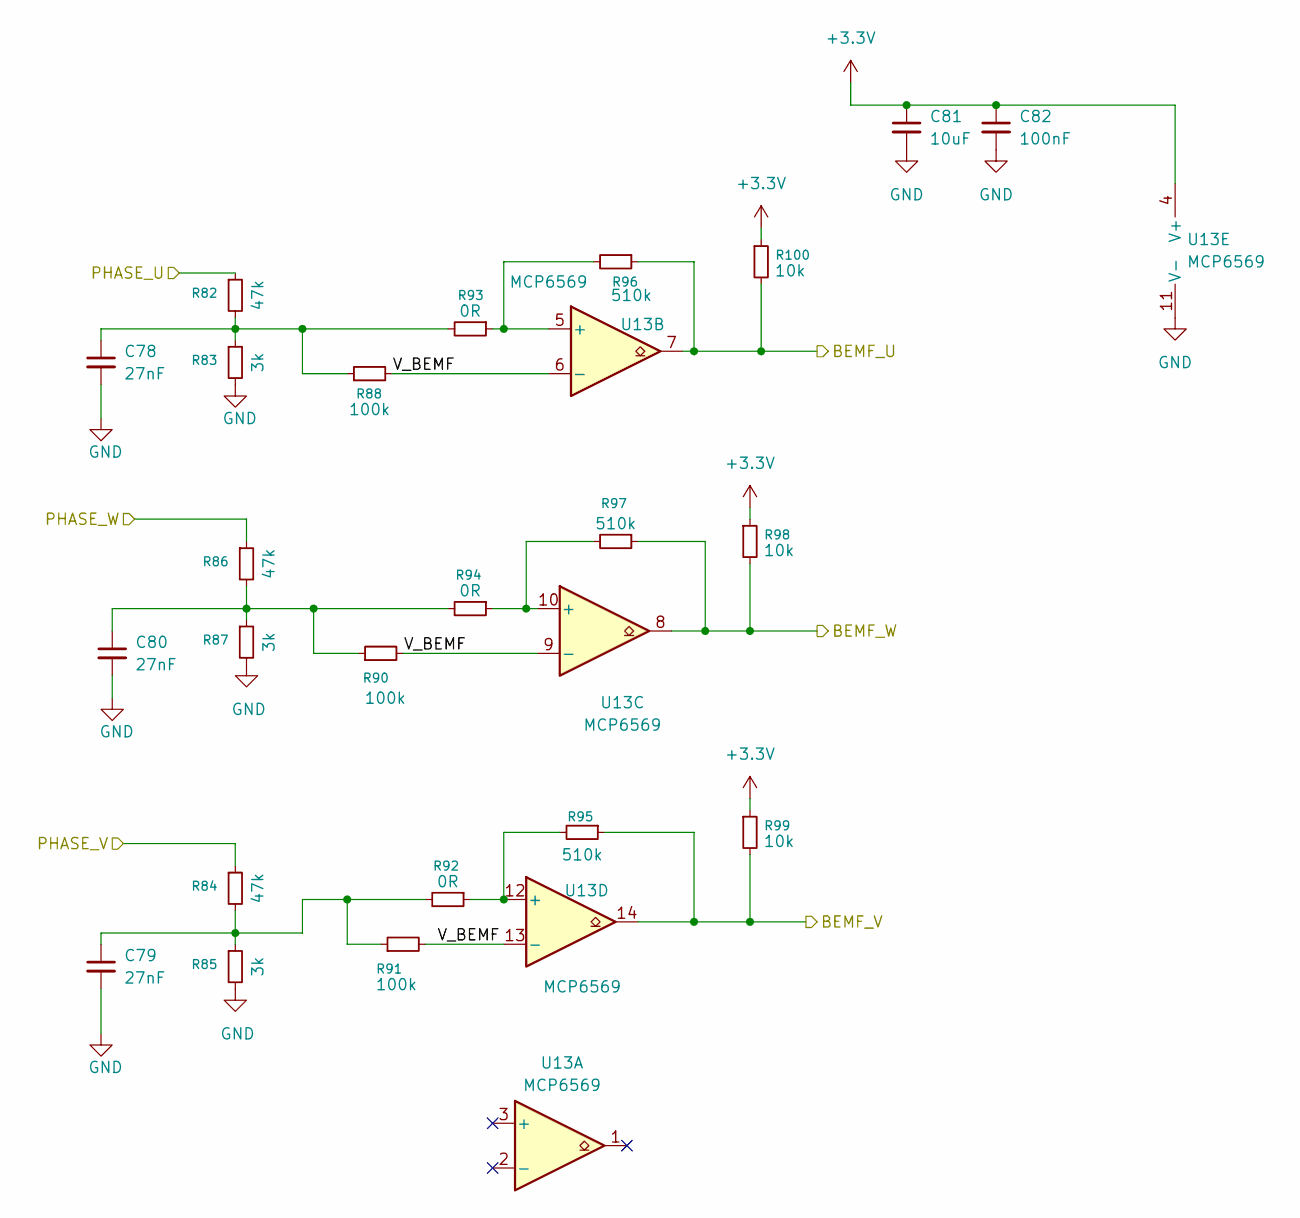
[picture p24: schematic BEMF_SENS.kicad_sch]

Parts:
C78, C79, C80: 27nF; C_0603_1608Metric
C81: 10uF; C_0603_1608Metric; LCSC C96446
C82: 100nF; C_0603_1608Metric; LCSC C14663
R82, R84, R86: 47k; R_0603_1608Metric; LCSC C25819
R83, R85, R87: 3k; R_0603_1608Metric; LCSC C4211
R88, R90, R91: 100k; R_0603_1608Metric; LCSC C25803
R92, R93, R94: 0R; R_0603_1608Metric; LCSC C21189
R95, R96, R97: 510k; R_0603_1608Metric; LCSC C23192
R98, R99, R100: 10k; R_0603_1608Metric; LCSC C25804
U13: MCP6569; SOIC-14_3.9x8.7mm_P1.27mm

Connections:
+3.3V: C81.1, C82.1, R98.1, R99.1, R100.1, U13.4 (V+); also elsewhere on the board
/BEMF_SENS/BEMF_U: R96.1, R100.2, U13.7; also elsewhere on the board
/BEMF_SENS/BEMF_V: R95.1, R99.2, U13.14; also elsewhere on the board
/BEMF_SENS/BEMF_W: R97.1, R98.2, U13.8; also elsewhere on the board
/BEMF_SENS/PHASE_U: R82.1; also elsewhere on the board
/BEMF_SENS/PHASE_V: R84.1; also elsewhere on the board
/BEMF_SENS/PHASE_W: R86.1; also elsewhere on the board
/BEMF_SENS/V_BEMF: R88.2, R90.2, R91.2, U13.6 (-), U13.9 (-), U13.13 (-)
GND: C78.2, C79.2, C80.2, C81.2, C82.2, R83.2, R85.2, R87.2, U13.11 (V-); also elsewhere on the board
unnamed: C78.1, R82.2, R83.1, R88.1, R93.2
unnamed: C79.1, R84.2, R85.1, R91.1, R92.2
unnamed: C80.1, R86.2, R87.1, R90.1, R94.2
unnamed: R93.1, R96.2, U13.5 (+)
unnamed: R94.1, R97.2, U13.10 (+)
unnamed: R92.1, R95.2, U13.12 (+)

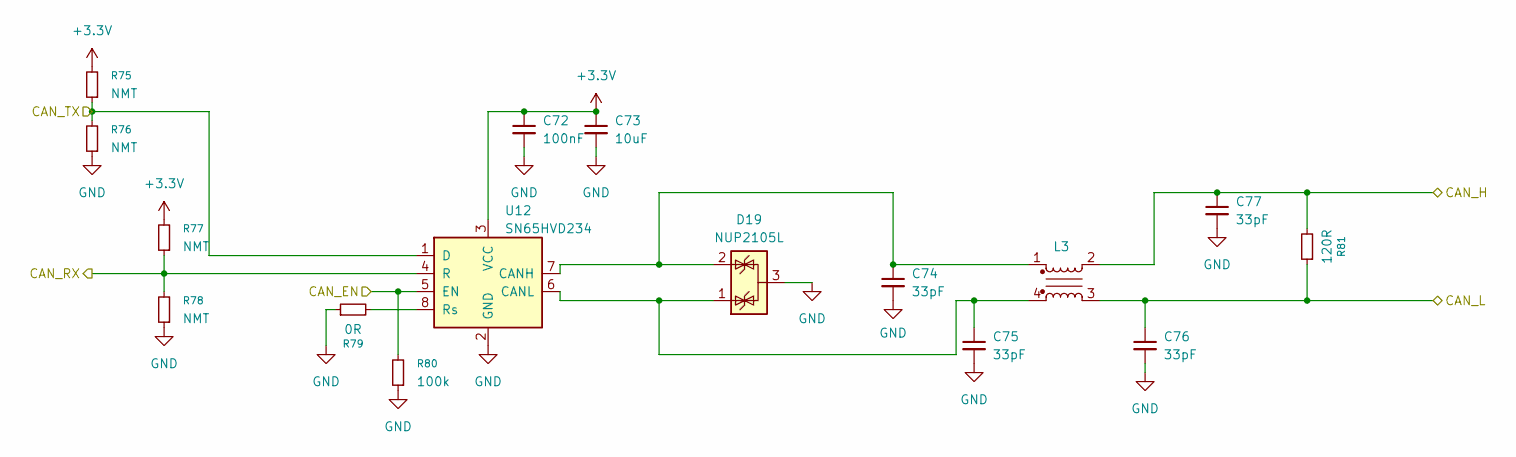
[picture p25: schematic CAN_TRANSCIEVER.kicad_sch]

Parts:
C72: 100nF; C_0603_1608Metric; LCSC C14663
C73: 10uF; C_0603_1608Metric; LCSC C96446
C74, C75, C76, C77: 33pF; C_0603_1608Metric; LCSC C1663
D19: NUP2105L; SOT-23
L3: Choke_Wurth_WE-CNSW_744232090; L_CommonMode_Wurth_WE-CNSW-1206
R75, R76, R77, R78: NMT; R_0603_1608Metric
R79: 0R; R_0603_1608Metric; LCSC C21189
R80: 100k; R_0603_1608Metric; LCSC C25803
R81: 120R; R_0603_1608Metric
U12: SN65HVD234; SOIC-8_3.9x4.9mm_P1.27mm

Connections:
+3.3V: C72.1, C73.1, R75.2, R77.2, U12.3 (VCC); also elsewhere on the board
/CAN_TRANSCIEVER/CAN_EN: R80.2, U12.5 (EN); also elsewhere on the board
/CAN_TRANSCIEVER/CAN_H: C77.1, L3.2, R81.2; also elsewhere on the board
/CAN_TRANSCIEVER/CAN_L: C76.1, L3.3, R81.1; also elsewhere on the board
/CAN_TRANSCIEVER/CAN_RX: R77.1, R78.2, U12.4 (R); also elsewhere on the board
/CAN_TRANSCIEVER/CAN_TX: R75.1, R76.2, U12.1 (D); also elsewhere on the board
GND: C72.2, C73.2, C74.2, C75.2, C76.2, C77.2, D19.3 (A), R76.1, R78.1, R79.1, R80.1, U12.2 (GND); also elsewhere on the board
unnamed: C74.1, D19.2 (K), L3.1, U12.7 (CANH)
unnamed: C75.1, D19.1 (K), L3.4, U12.6 (CANL)
unnamed: R79.2, U12.8 (Rs)

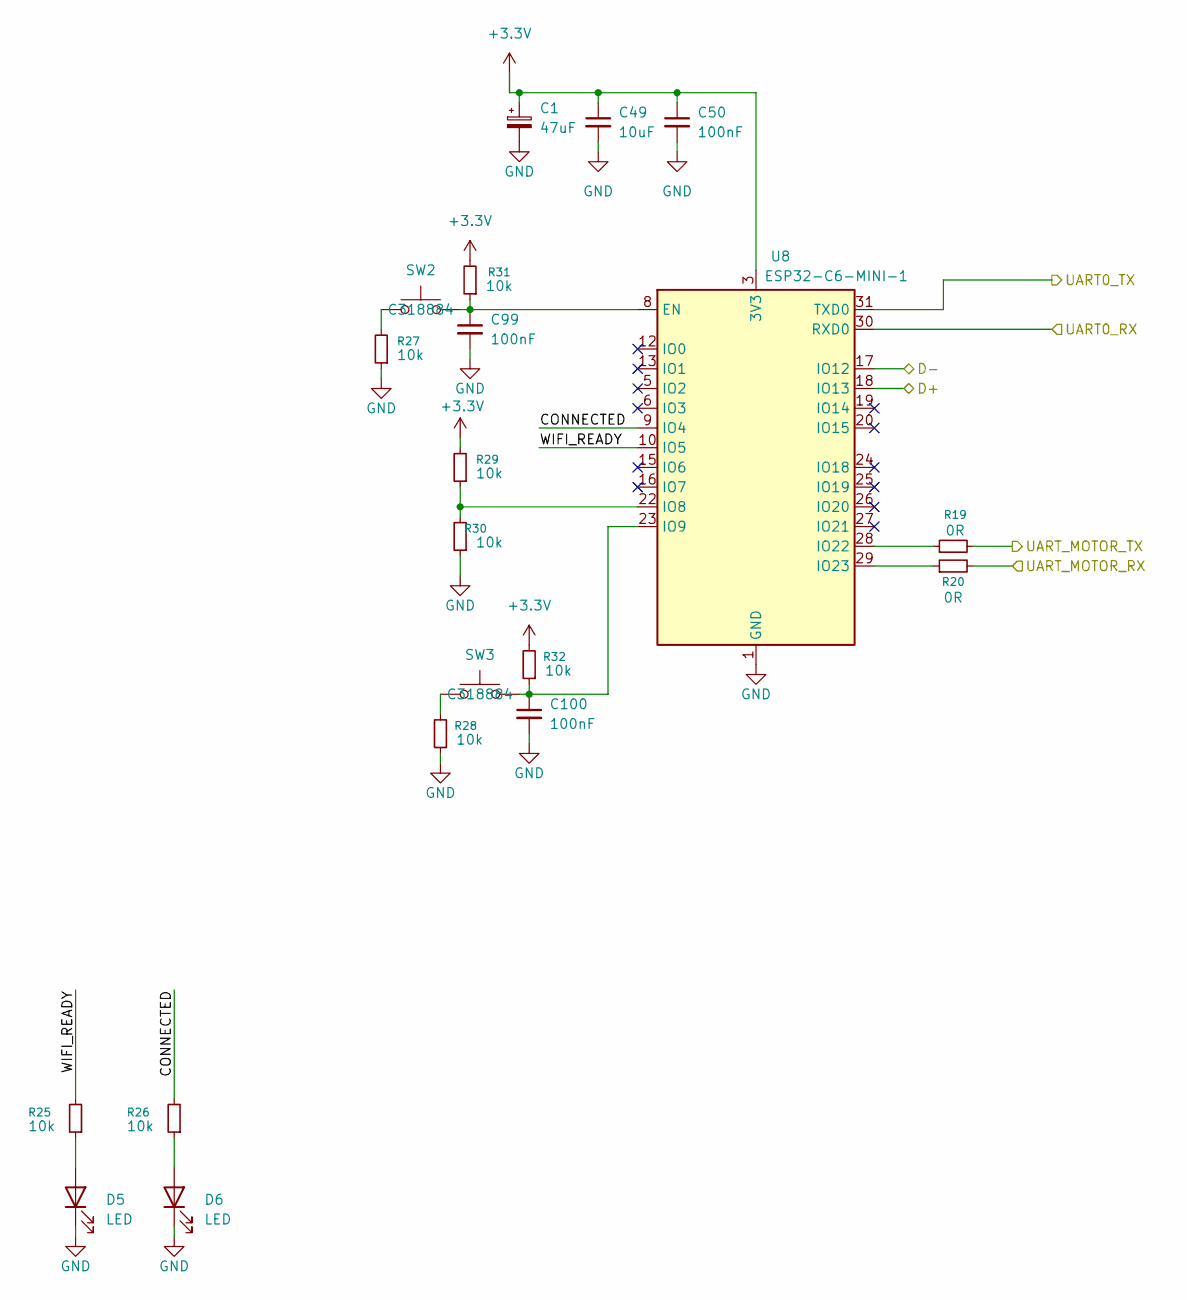
[picture p26: schematic RADIO.kicad_sch]

Parts:
C1: 47uF; CP_EIA-6032-15_Kemet-U
C49: 10uF; C_0603_1608Metric; LCSC C96446
C50, C99, C100: 100nF; C_0603_1608Metric; LCSC C14663
D5, D6: LED; LED_0603_1608Metric; LCSC C2286
R19, R20: 0R; R_0402_1005Metric; LCSC C17168
R25, R26, R27, R28, R29, R30, R31, R32: 10k; R_0603_1608Metric; LCSC C25804
SW2, SW3: SW_Push; SW_SPST_TL3342; LCSC C318884
U8: ESP32-C6-MINI-1; XCVR_ESP32-C6-MINI-1-H4

Connections:
+3.3V: C1.1, C49.1, C50.1, R29.2, R31.2, R32.2, U8.3 (3V3); also elsewhere on the board
/MCU/UART_MOTOR_RX: R19.2; also elsewhere on the board
/MCU/UART_MOTOR_TX: R20.2; also elsewhere on the board
/RADIO/CONNECTED: R26.2, U8.9 (IO4)
/RADIO/D+: U8.18 (IO13); also elsewhere on the board
/RADIO/D-: U8.17 (IO12); also elsewhere on the board
/RADIO/UART0_RX: U8.30 (RXD0); also elsewhere on the board
/RADIO/UART0_TX: U8.31 (TXD0); also elsewhere on the board
/RADIO/WIFI_READY: R25.2, U8.10 (IO5)
GND: C1.2, C49.2, C50.2, C99.2, C100.2, D5.1 (K), D6.1 (K), R27.1, R28.1, R30.1, U8.1 (GND), U8.2 (GND), U8.11 (GND), U8.14 (GND), U8.36 (GND), U8.37 (GND), U8.38 (GND), U8.39 (GND), U8.40 (GND), U8.41 (GND), U8.42 (GND), U8.43 (GND), U8.44 (GND), U8.45 (GND), U8.46 (GND), U8.47 (GND), U8.48 (GND), U8.49 (GND), U8.49_1 (GND), U8.49_2 (GND), U8.49_3 (GND), U8.49_4 (GND), U8.49_5 (GND), U8.49_6 (GND), U8.49_7 (GND), U8.49_8 (GND), U8.49_9 (GND), U8.50 (GND), U8.51 (GND), U8.52 (GND), U8.53 (GND); also elsewhere on the board
unnamed: D5.2 (A), R25.1
unnamed: D6.2 (A), R26.1
unnamed: R27.2, SW2.1
unnamed: R28.2, SW3.1
unnamed: C99.1, R31.1, SW2.2, U8.8 (EN)
unnamed: R29.1, R30.2, U8.22 (IO8)
unnamed: C100.1, R32.1, SW3.2, U8.23 (IO9)
unnamed: R19.1, U8.28 (IO22)
unnamed: R20.1, U8.29 (IO23)

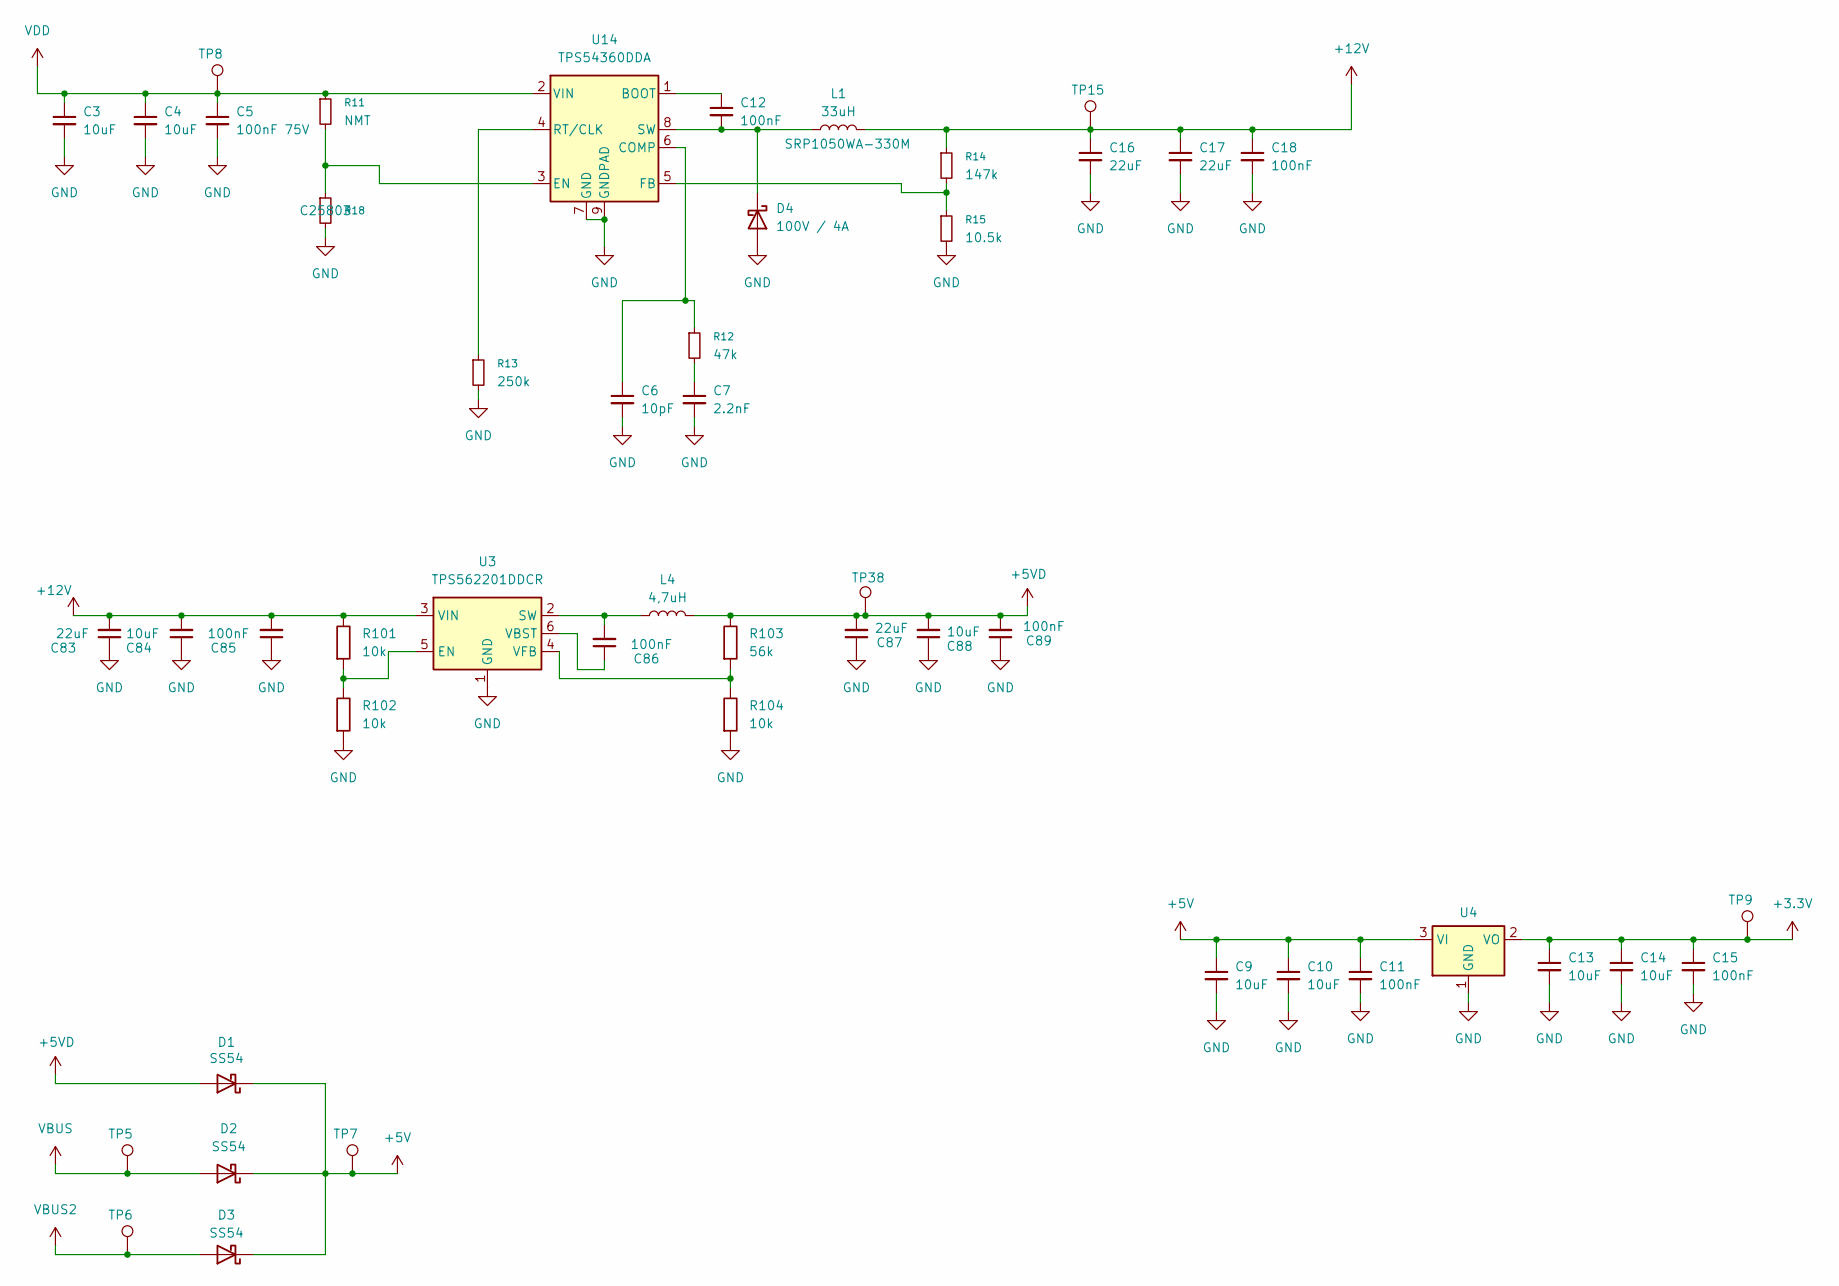
[picture p27: schematic PSU.kicad_sch]

Parts:
C3, C4: 10uF; C_1210_3225Metric
C5: 100nF 75V; C_0805_2012Metric; LCSC C28233
C6: 10pF; C_0603_1608Metric; LCSC C1634
C7: 2.2nF; C_0805_2012Metric; LCSC C28260
C9, C10, C13, C14, C84, C88: 10uF; C_0603_1608Metric; LCSC C96446
C11, C12, C15, C18, C85, C86, C89: 100nF; C_0603_1608Metric; LCSC C14663
C16, C17, C83, C87: 22uF; C_0805_2012Metric; LCSC C45783
D1, D2, D3: SS54; D_SMA; LCSC C22452
D4: 100V / 4A; D_SMB_Handsoldering
L1: 33uH; L_Bourns_SRP1050WA
L4: 4,7uH; INDPM5452X300N
R11: NMT; R_0603_1608Metric
R12: 47k; R_0603_1608Metric; LCSC C25819
R13: 250k; R_0603_1608Metric
R14: 147k; R_0603_1608Metric
R15: 10.5k; R_0603_1608Metric
R18: 100k; R_0603_1608Metric; LCSC C25803
R101, R102, R104: 10k; R_0603_1608Metric; LCSC C25804
R103: 56k; R_0603_1608Metric; LCSC C23206
TP5, TP6, TP7, TP8, TP9, TP15, TP38: TestPoint; TestPoint_Pad_D2.0mm
U3: TPS562201DDCR; SOT-23-6_Handsoldering
U4: AMS1117-3.3; SOT-223-3_TabPin2; LCSC C6186
U14: TPS54360DDA; TI_SO-PowerPAD-8_ThermalVias

Connections:
+3.3V: C13.1, C14.1, C15.1, TP9.1, U4.2 (VO); also elsewhere on the board
+5V: C9.1, C10.1, C11.1, D1.1 (K), D2.1 (K), D3.1 (K), TP7.1, U4.3 (VI); also elsewhere on the board
+5VD: C87.2, C88.2, C89.2, D1.2 (A), L4.2, R103.2, TP38.1
+12V: C16.1, C17.1, C18.1, C83.2, C84.2, C85.2, L1.2, R14.1, R101.2, TP15.1, U3.3 (VIN); also elsewhere on the board
GND: C3.2, C4.2, C5.2, C6.2, C7.2, C9.2, C10.2, C11.2, C13.2, C14.2, C15.2, C16.2, C17.2, C18.2, C83.1, C84.1, C85.1, C87.1, C88.1, C89.1, D4.2 (A), R13.2, R15.2, R18.2, R102.1, R104.1, U3.1 (GND), U4.1 (GND), U14.7 (GND), U14.9 (GNDPAD); also elsewhere on the board
unnamed: C7.1, R12.2
unnamed: C12.2, D4.1 (K), L1.1, U14.8 (SW)
unnamed: R101.1, R102.2, U3.5 (EN)
unnamed: C86.2, L4.1, U3.2 (SW)
unnamed: C86.1, U3.6 (VBST)
unnamed: R103.1, R104.2, U3.4 (VFB)
unnamed: C12.1, U14.1 (BOOT)
unnamed: C6.1, R12.1, U14.6 (COMP)
unnamed: R11.2, R18.1, U14.3 (EN)
unnamed: R14.2, R15.1, U14.5 (FB)
unnamed: R13.1, U14.4 (RT/CLK)
VBUS: D2.2 (A), TP5.1; also elsewhere on the board
VBUS2: D3.2 (A), TP6.1; also elsewhere on the board
VDD: C3.1, C4.1, C5.1, R11.1, TP8.1, U14.2 (VIN); also elsewhere on the board

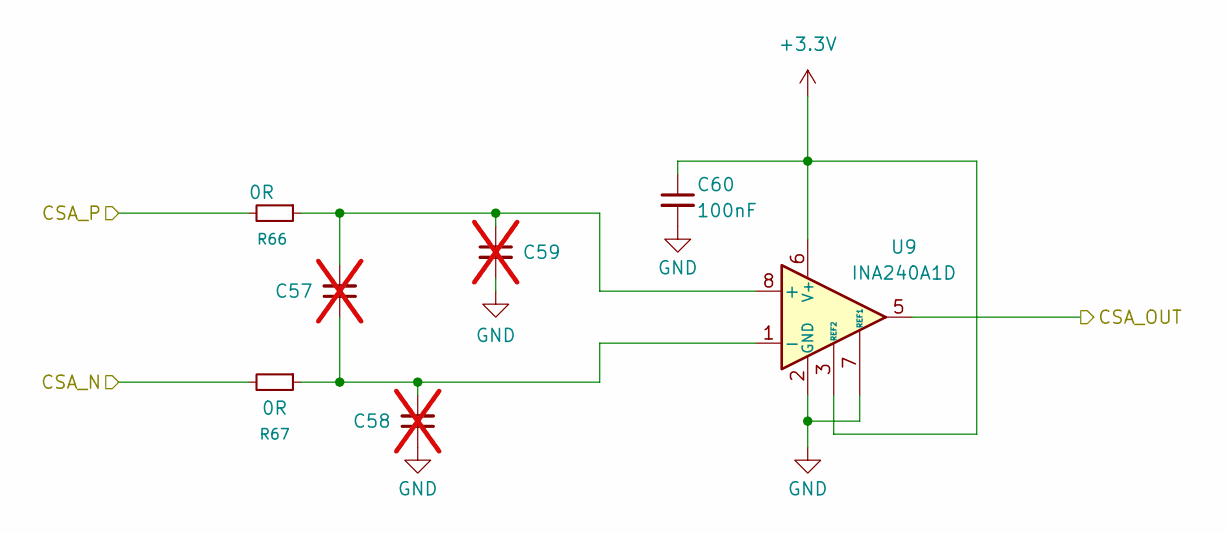
[picture p28: schematic CSA.kicad_sch]

Parts:
C57, C58, C59: C_Small; C_0603_1608Metric; not fitted
C60: 100nF; C_0603_1608Metric; LCSC C14663
R66, R67: 0R; R_0603_1608Metric; LCSC C21189
U9: INA240A1D; SOIC-8_3.9x4.9mm_P1.27mm

Connections:
+3.3V: C60.1, U9.3 (REF2), U9.6 (V+); also elsewhere on the board
/BEMF_SENS/PHASE_V: R67.2; also elsewhere on the board
/MCU/ADC_CSA_V: U9.5; also elsewhere on the board
/MOTOR_CTRL/CSA/CSA_P: R66.2; also elsewhere on the board
GND: C58.1, C59.2, C60.2, U9.2 (GND), U9.4 (GND), U9.7 (REF1); also elsewhere on the board
unnamed: C57.2, C59.1, R66.1, U9.8 (+)
unnamed: C57.1, C58.2, R67.1, U9.1 (-)

Parts of its further copies:
C61, C62, C63, C65, C66, C67: C_Small; C_0603_1608Metric; not fitted
C64, C68: 100nF; C_0603_1608Metric; LCSC C14663
R68, R69, R70, R71: 0R; R_0603_1608Metric; LCSC C21189
U10, U11: INA240A1D; SOIC-8_3.9x4.9mm_P1.27mm

Connections of its further copies:
+3.3V: C64.1, C68.1, U10.3 (REF2), U10.6 (V+), U11.3 (REF2), U11.6 (V+); also elsewhere on the board
/BEMF_SENS/PHASE_U: R71.2; also elsewhere on the board
/BEMF_SENS/PHASE_W: R69.2; also elsewhere on the board
/MCU/ADC_CSA_U: U11.5; also elsewhere on the board
/MCU/ADC_CSA_W: U10.5; also elsewhere on the board
/MOTOR_CTRL/CSA1/CSA_P: R68.2; also elsewhere on the board
/MOTOR_CTRL/CSA2/CSA_P: R70.2; also elsewhere on the board
GND: C62.1, C63.2, C64.2, C66.1, C67.2, C68.2, U10.2 (GND), U10.4 (GND), U10.7 (REF1), U11.2 (GND), U11.4 (GND), U11.7 (REF1); also elsewhere on the board
unnamed: C61.2, C63.1, R68.1, U10.8 (+)
unnamed: C61.1, C62.2, R69.1, U10.1 (-)
unnamed: C65.2, C67.1, R70.1, U11.8 (+)
unnamed: C65.1, C66.2, R71.1, U11.1 (-)
