tetes20/bldc_driver/bldc_driver_hw/bldc_driver_hw.kicad_pcb

## KiCad design bldc_driver_hw/bldc_driver_hw.kicad_pcb (continued)

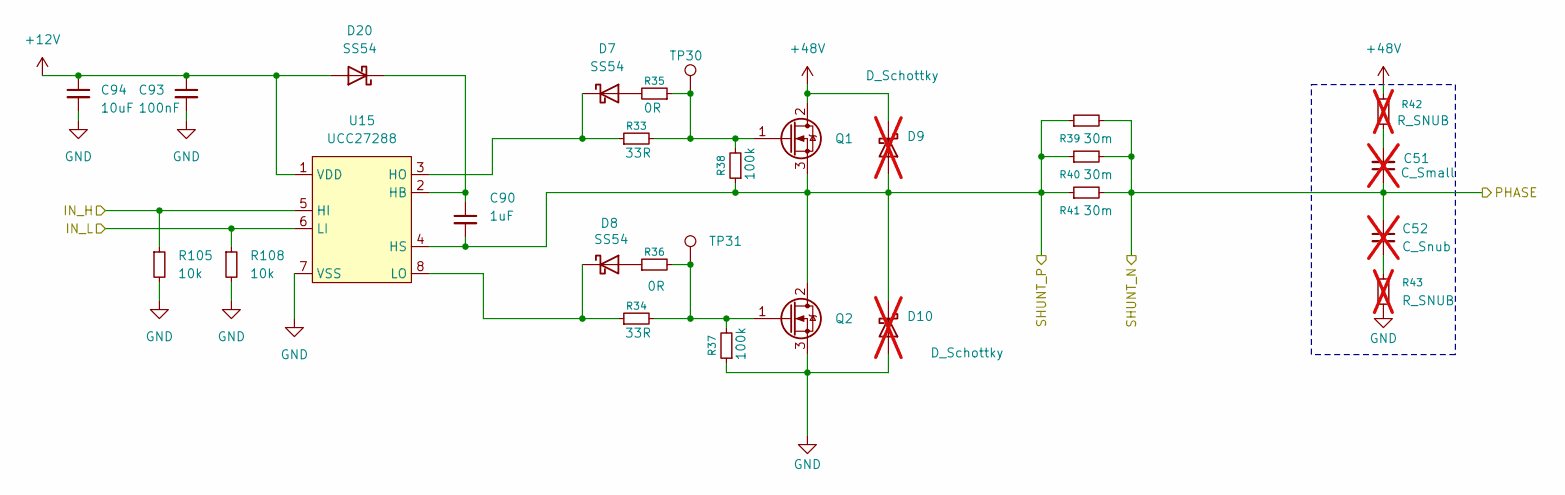
[picture p29: schematic H_BRIDGE.kicad_sch]

Parts:
C51: C_Small; C_1206_3216Metric; not fitted
C52: C_Snub; C_1206_3216Metric; not fitted
C90: 1uF; C_0603_1608Metric; LCSC C15849
C93: 100nF; C_0603_1608Metric; LCSC C14663
C94: 10uF; C_0603_1608Metric; LCSC C96446
D7, D8, D20: SS54; D_SMA; LCSC C22452
D9, D10: D_Schottky; D_SMB; not fitted
Q1, Q2: IPB026N06NATMA1; TO-263-2
R33, R34: 33R; R_0805_2012Metric; LCSC C17634
R35, R36: 0R; R_0805_2012Metric; LCSC C17477
R37, R38: 100k; R_0805_2012Metric; LCSC C149504
R39, R40, R41: 30m; R_2512_6332Metric
R42, R43: R_SNUB; R_1206_3216Metric; not fitted
R105, R108: 10k; R_0603_1608Metric; LCSC C25804
TP30, TP31: TestPoint; TestPoint_Pad_D2.0mm
U15: UCC27288; SOIC-8_3.9x4.9mm_P1.27mm

Connections:
+12V: C93.1, C94.1, D20.2 (A), U15.1 (VDD); also elsewhere on the board
+48V: D9.1 (K), Q1.2 (D), R42.2; also elsewhere on the board
/BEMF_SENS/PHASE_U: C51.1, C52.1, R39.2, R40.2, R41.2; also elsewhere on the board
/MCU/IN_H_U: R105.1, U15.5 (HI); also elsewhere on the board
/MCU/IN_L_U: R108.1, U15.6 (LI); also elsewhere on the board
/MOTOR_CTRL/CSA2/CSA_P: C90.2, D9.2 (A), D10.1 (K), Q1.3 (S), Q2.2 (D), R38.1, R39.1, R40.1, R41.1, U15.4 (HS); also elsewhere on the board
GND: C93.2, C94.2, D10.2 (A), Q2.3 (S), R37.1, R43.2, R105.2, R108.2, U15.7 (VSS); also elsewhere on the board
unnamed: C51.2, R42.1
unnamed: C52.2, R43.1
unnamed: D7.2 (A), R35.2
unnamed: D7.1 (K), R33.1, U15.3 (HO)
unnamed: D8.2 (A), R36.1
unnamed: D8.1 (K), R34.1, U15.8 (LO)
unnamed: C90.1, D20.1 (K), U15.2 (HB)
unnamed: Q1.1 (G), R33.2, R35.1, R38.2, TP30.1
unnamed: Q2.1 (G), R34.2, R36.2, R37.2, TP31.1

Parts of its further copies:
C53, C55: C_Small; C_1206_3216Metric; not fitted
C54, C56: C_Snub; C_1206_3216Metric; not fitted
C91, C92: 1uF; C_0603_1608Metric; LCSC C15849
C95, C97: 100nF; C_0603_1608Metric; LCSC C14663
C96, C98: 10uF; C_0603_1608Metric; LCSC C96446
D11, D12, D15, D16, D21, D22: SS54; D_SMA; LCSC C22452
D13, D14, D17, D18: D_Schottky; D_SMB; not fitted
Q3, Q4, Q5, Q6: IPB026N06NATMA1; TO-263-2
R44, R45, R55, R56: 33R; R_0805_2012Metric; LCSC C17634
R46, R47, R57, R58: 0R; R_0805_2012Metric; LCSC C17477
R48, R49, R59, R60: 100k; R_0805_2012Metric; LCSC C149504
R50, R51, R52, R61, R62, R63: 30m; R_2512_6332Metric
R53, R54, R64, R65: R_SNUB; R_1206_3216Metric; not fitted
R106, R107, R109, R110: 10k; R_0603_1608Metric; LCSC C25804
TP32, TP33, TP34, TP35: TestPoint; TestPoint_Pad_D2.0mm
U16, U17: UCC27288; SOIC-8_3.9x4.9mm_P1.27mm

Connections of its further copies:
+12V: C95.1, C96.1, C97.1, C98.1, D21.2 (A), D22.2 (A), U16.1 (VDD), U17.1 (VDD); also elsewhere on the board
+48V: D13.1 (K), D17.1 (K), Q3.2 (D), Q5.2 (D), R53.2, R64.2; also elsewhere on the board
/BEMF_SENS/PHASE_V: C55.1, C56.1, R61.2, R62.2, R63.2; also elsewhere on the board
/BEMF_SENS/PHASE_W: C53.1, C54.1, R50.2, R51.2, R52.2; also elsewhere on the board
/MCU/IN_H_V: R107.1, U17.5 (HI); also elsewhere on the board
/MCU/IN_H_W: R106.1, U16.5 (HI); also elsewhere on the board
/MCU/IN_L_V: R110.1, U17.6 (LI); also elsewhere on the board
/MCU/IN_L_W: R109.1, U16.6 (LI); also elsewhere on the board
/MOTOR_CTRL/CSA1/CSA_P: C91.2, D13.2 (A), D14.1 (K), Q3.3 (S), Q4.2 (D), R49.1, R50.1, R51.1, R52.1, U16.4 (HS); also elsewhere on the board
/MOTOR_CTRL/CSA/CSA_P: C92.2, D17.2 (A), D18.1 (K), Q5.3 (S), Q6.2 (D), R60.1, R61.1, R62.1, R63.1, U17.4 (HS); also elsewhere on the board
GND: C95.2, C96.2, C97.2, C98.2, D14.2 (A), D18.2 (A), Q4.3 (S), Q6.3 (S), R48.1, R54.2, R59.1, R65.2, R106.2, R107.2, R109.2, R110.2, U16.7 (VSS), U17.7 (VSS); also elsewhere on the board
unnamed: C53.2, R53.1
unnamed: C54.2, R54.1
unnamed: C55.2, R64.1
unnamed: C56.2, R65.1
unnamed: D11.2 (A), R46.2
unnamed: D11.1 (K), R44.1, U16.3 (HO)
unnamed: D12.2 (A), R47.1
unnamed: D12.1 (K), R45.1, U16.8 (LO)
unnamed: D15.2 (A), R57.2
unnamed: D15.1 (K), R55.1, U17.3 (HO)
unnamed: D16.2 (A), R58.1
unnamed: D16.1 (K), R56.1, U17.8 (LO)
unnamed: C91.1, D21.1 (K), U16.2 (HB)
unnamed: C92.1, D22.1 (K), U17.2 (HB)
unnamed: Q3.1 (G), R44.2, R46.1, R49.2, TP32.1
unnamed: Q4.1 (G), R45.2, R47.2, R48.2, TP33.1
unnamed: Q5.1 (G), R55.2, R57.1, R60.2, TP34.1
unnamed: Q6.1 (G), R56.2, R58.2, R59.2, TP35.1

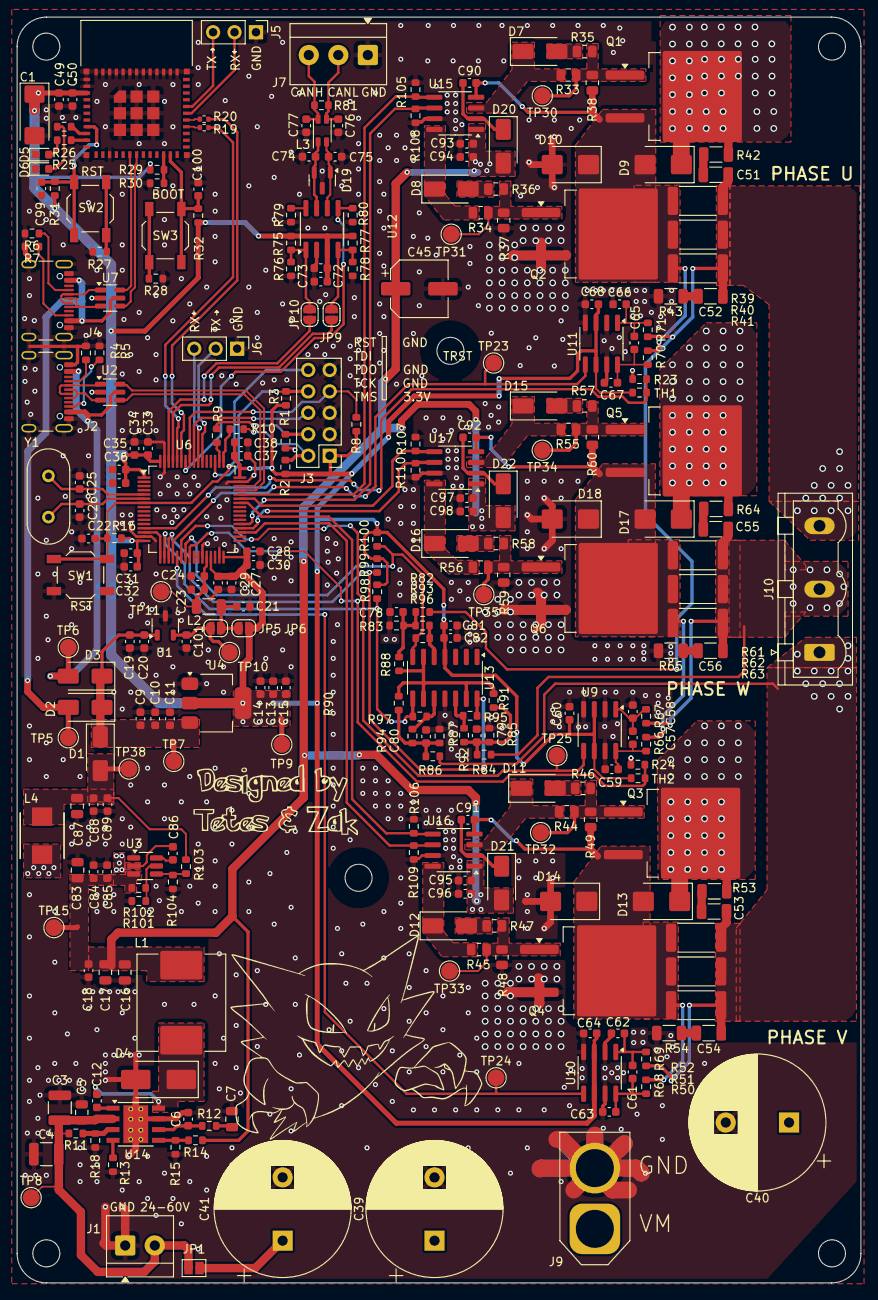
[picture p30: board bldc_driver_hw.kicad_pcb from above]

Board: 2 copper layers, 100.0 x 150.0 mm, 285 parts (0 on the bottom side), 133 nets.
