tetes20/bldc_driver/(commit log)

2025-04-03 hw init
    [MCU.kicad_sch, MOTOR_CTRL.kicad_sch, PSU.kicad_sch, RADIO.kicad_sch, bldc_driver_hw.kicad_pcb, bldc_driver_hw.kicad_sch]
2025-04-08 schematic finished pcb in progress
    [BEMF_SENS.kicad_sch, CAN_TRANSCIEVER.kicad_sch, CSA.kicad_sch, HALL_EFF_SENSOR.kicad_sch, H_BRIDGE.kicad_sch, MCU.kicad_sch, MOTOR_CTRL.kicad_sch, MR60-F.stp]
2025-04-08 Changed one 3 phase driver to three h-bridges and changed buck converter which sink more current
    [BEMF_SENS.kicad_sch, H_BRIDGE.kicad_sch, H_DRIVER.kicad_sch, LMLP0506M4R7DTAS.stp, MOTOR_CTRL.kicad_sch, PSU.kicad_sch, bldc_driver_hw.kicad_pcb]
2025-04-09 Board finished to review
    [BEMF_SENS.kicad_sch, CAN_TRANSCIEVER.kicad_sch, CSA.kicad_sch, ESP32-C6-MINI-1-H4.step, HALL_EFF_SENSOR.kicad_sch, H_BRIDGE.kicad_sch, MOTOR_CTRL.kicad_sch, PSU.kicad_sch]
2025-04-10 board finished
    [BEMF_SENS.kicad_sch, H_BRIDGE.kicad_sch, MCU.kicad_sch, RADIO.kicad_sch, bldc_driver_hw.kicad_pcb, bldc_driver_hw.kicad_sch]
2025-04-15 added lcsc codes
    [BEMF_SENS.kicad_sch, CAN_TRANSCIEVER.kicad_sch, CSA.kicad_sch, H_BRIDGE.kicad_sch, MCU.kicad_sch, MOTOR_CTRL.kicad_sch, PSU.kicad_sch, RADIO.kicad_sch]
2025-04-16 Changed size of capacitors at input 48V dc converter
    [BEMF_SENS.kicad_sch, PSU.kicad_sch, bldc_driver_hw.kicad_pcb, bldc_driver_hw.kicad_sch]
2025-04-16 changed vref
    [MCU.kicad_sch, bldc_driver_hw.kicad_pcb, bldc_driver_hw.kicad_sch, bom.csv, designators.csv, positions.csv]
2025-04-18 changed hrtim to tim1
    [MCU.kicad_sch, PSU.kicad_sch, RADIO.kicad_sch, bldc_driver_hw.kicad_pcb, bom.csv, designators.csv, positions.csv]
